zizhenji/ECE295_subsystemA-B/diagrams/prototype/subB_FFT.jpg

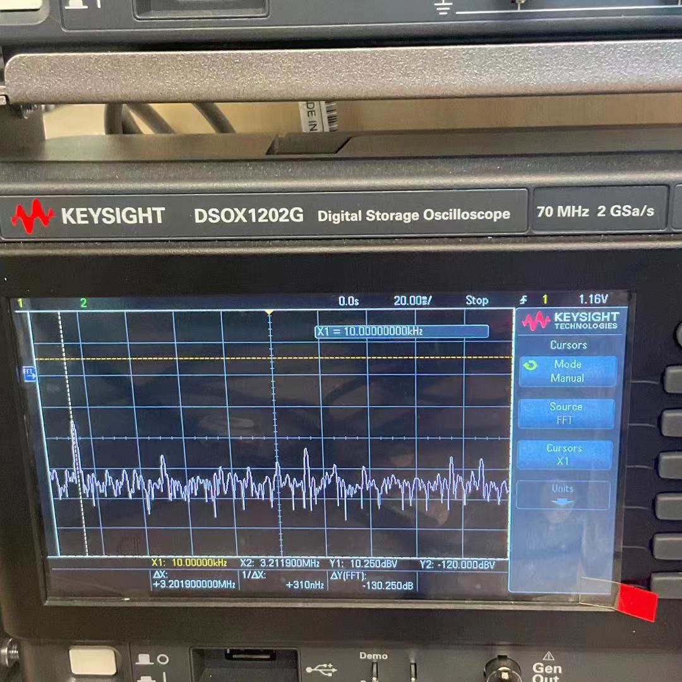
diagrams/prototype/subB_FFT.jpg
