zizhenji/ECE295_subsystemA-B/diagrams/flywire.jpg

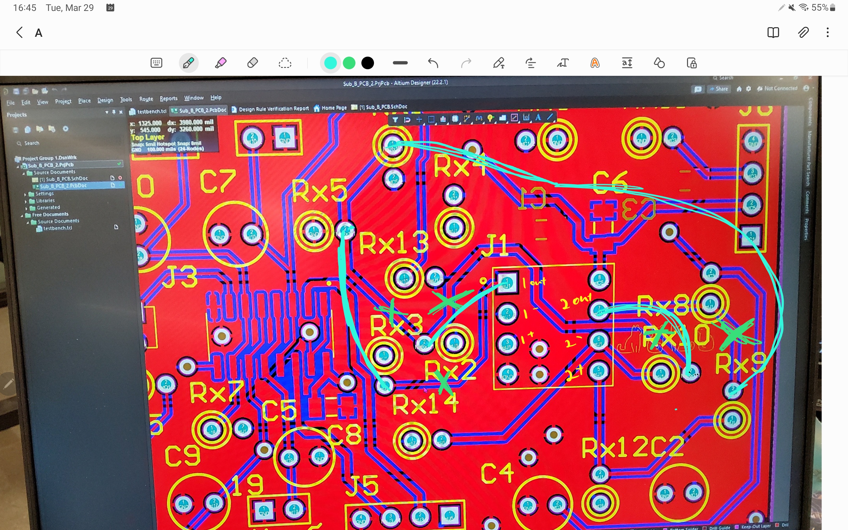
diagrams/flywire.jpg
