zizhenji/ECE295_subsystemA-B/diagrams/8MHz_drop.png

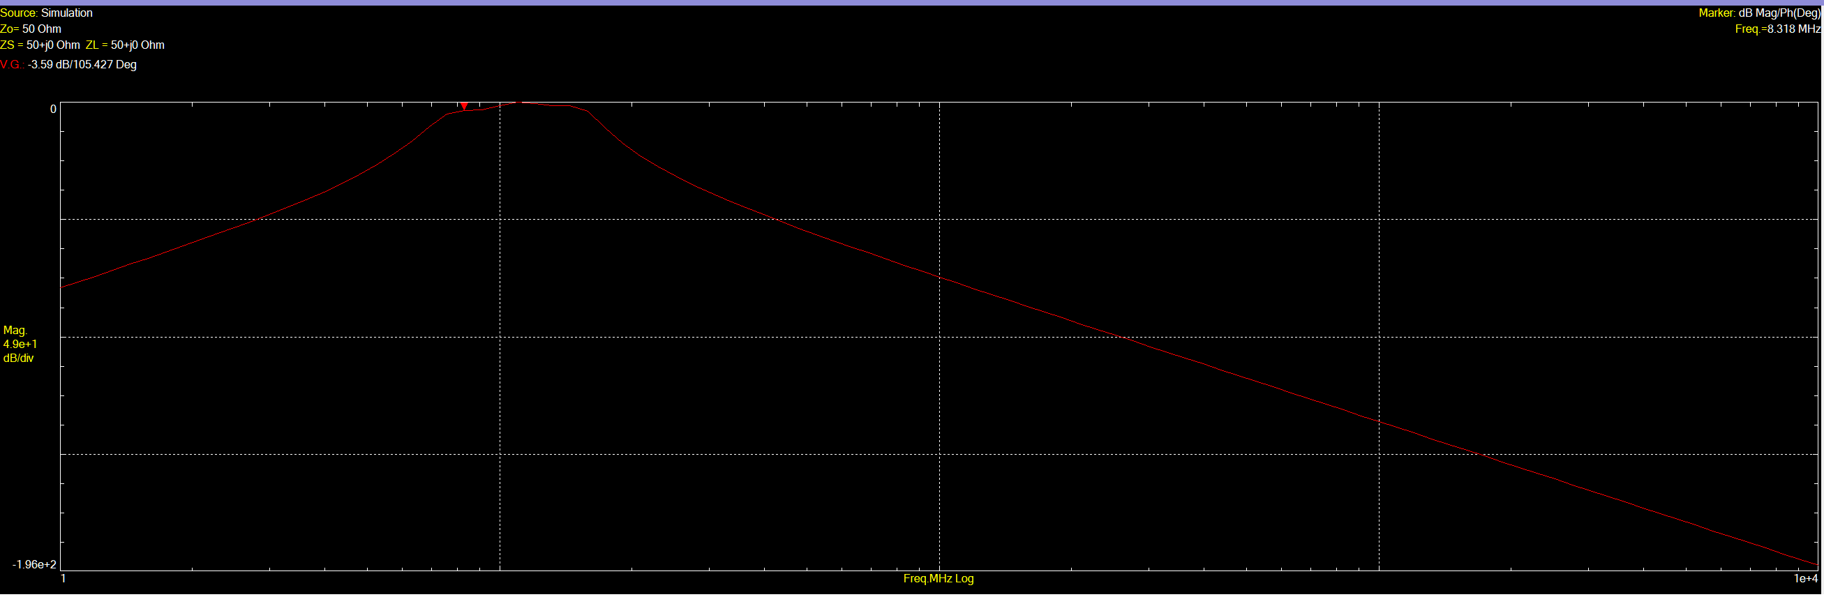
diagrams/8MHz_drop.png
