zizhenji/ECE295_subsystemA-B/diagrams/16MHz_drop.png

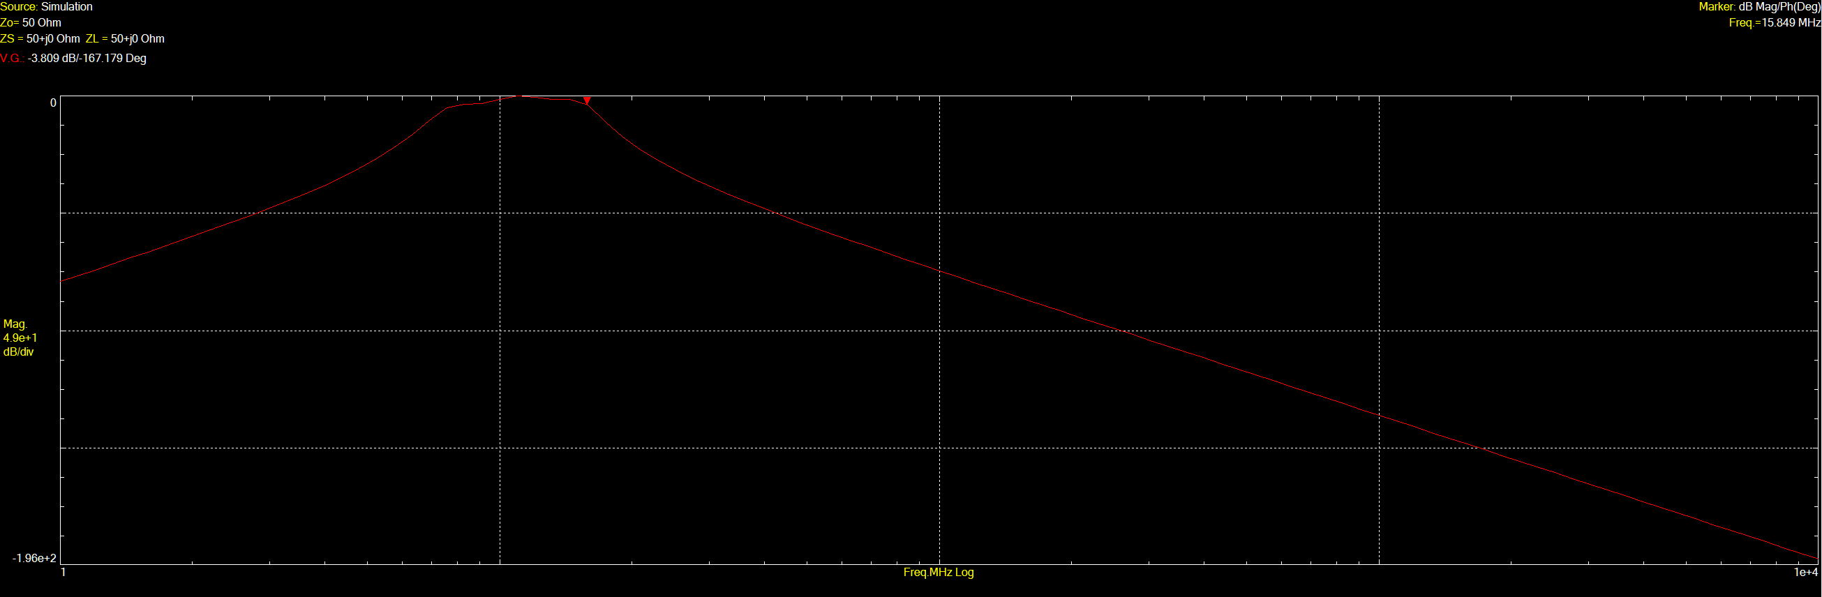
diagrams/16MHz_drop.png
