zizhenji/ECE295_subsystemA-B/diagrams/96kHz_LPF.png

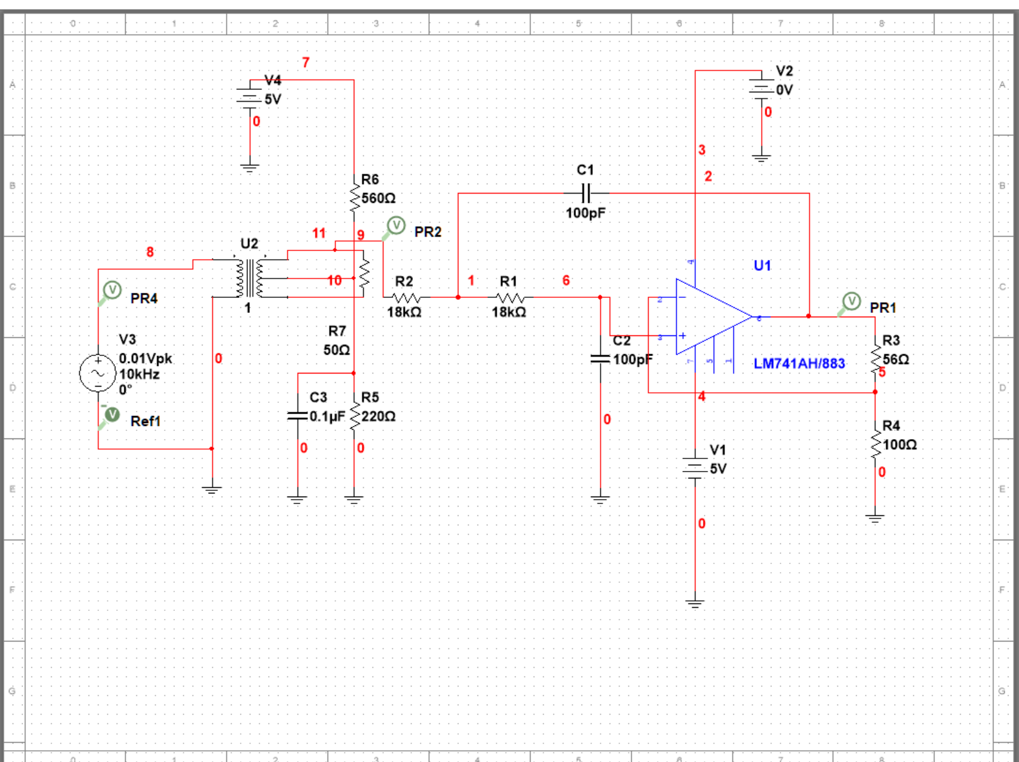
diagrams/96kHz_LPF.png
