zizhenji/ECE295_subsystemA-B/diagrams/A_BPF_sche.png

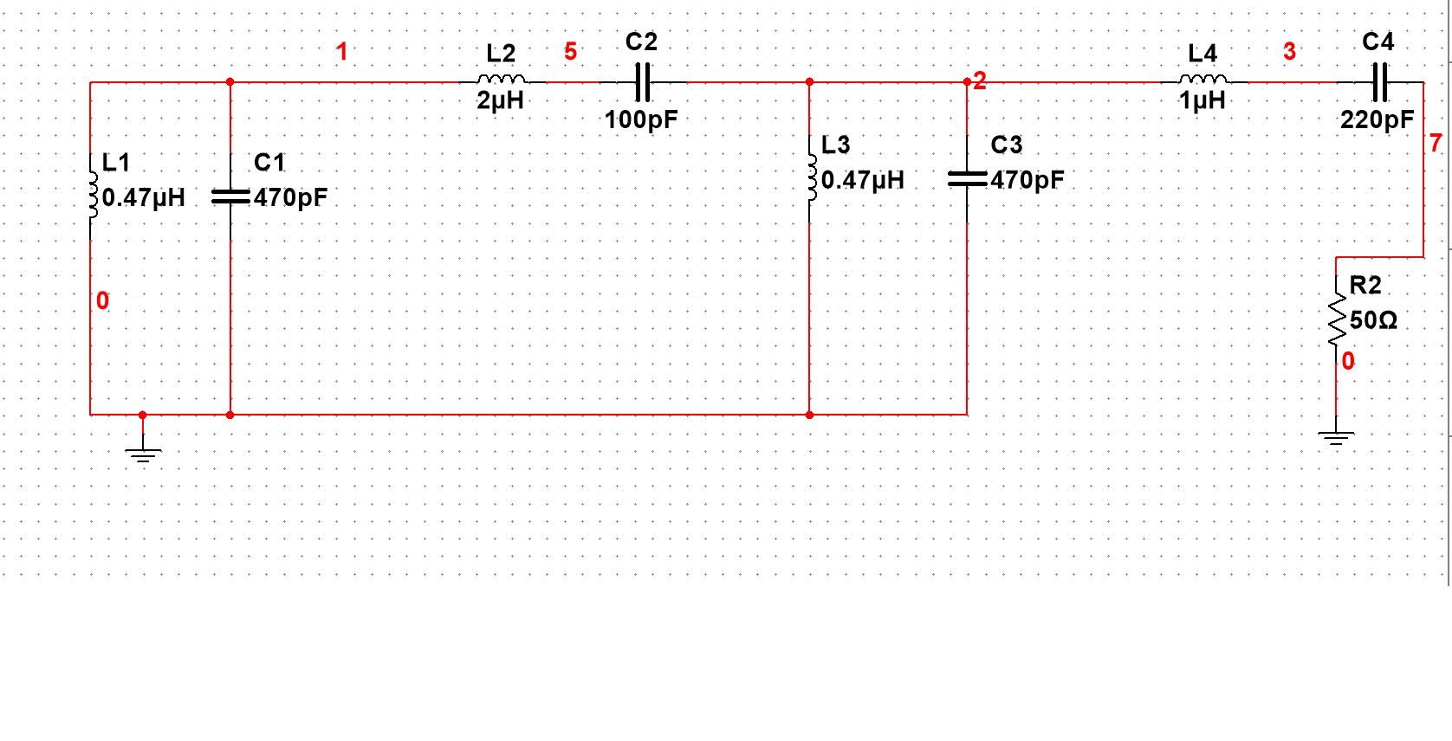
diagrams/A_BPF_sche.png
