zizhenji/ECE295_subsystemA-B/diagrams/I_fourier.png

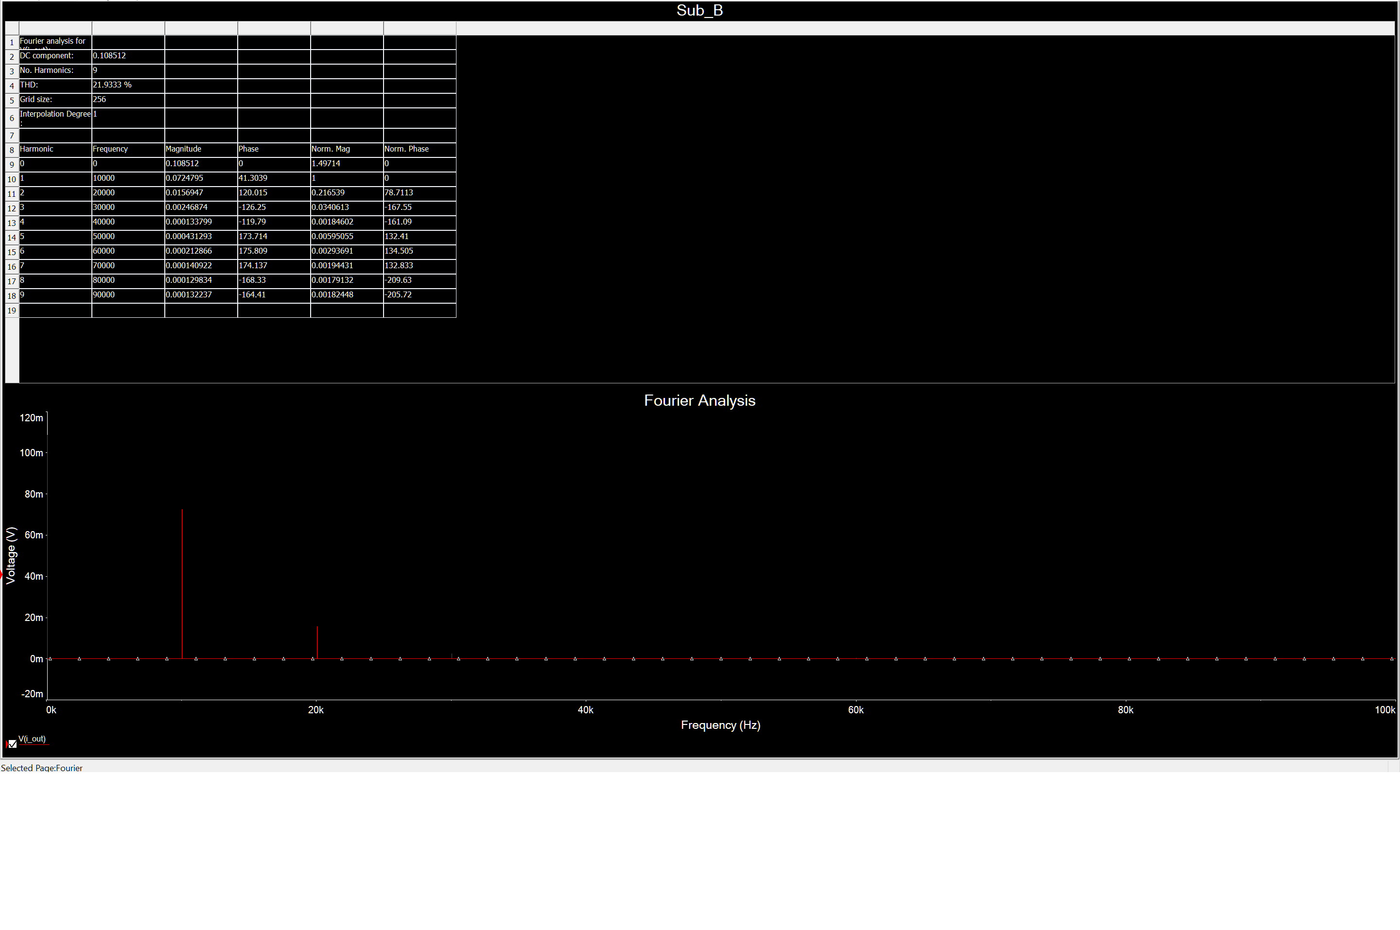
diagrams/I_fourier.png
