zizhenji/ECE295_subsystemA-B/diagrams/limiter_clip.png

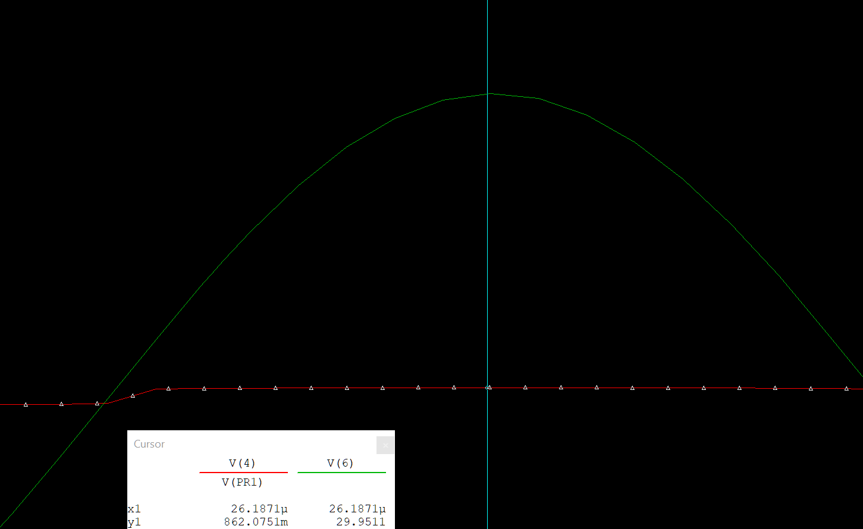
diagrams/limiter_clip.png
