zizhenji/ECE295_subsystemA-B/diagrams/limiter_sche.png

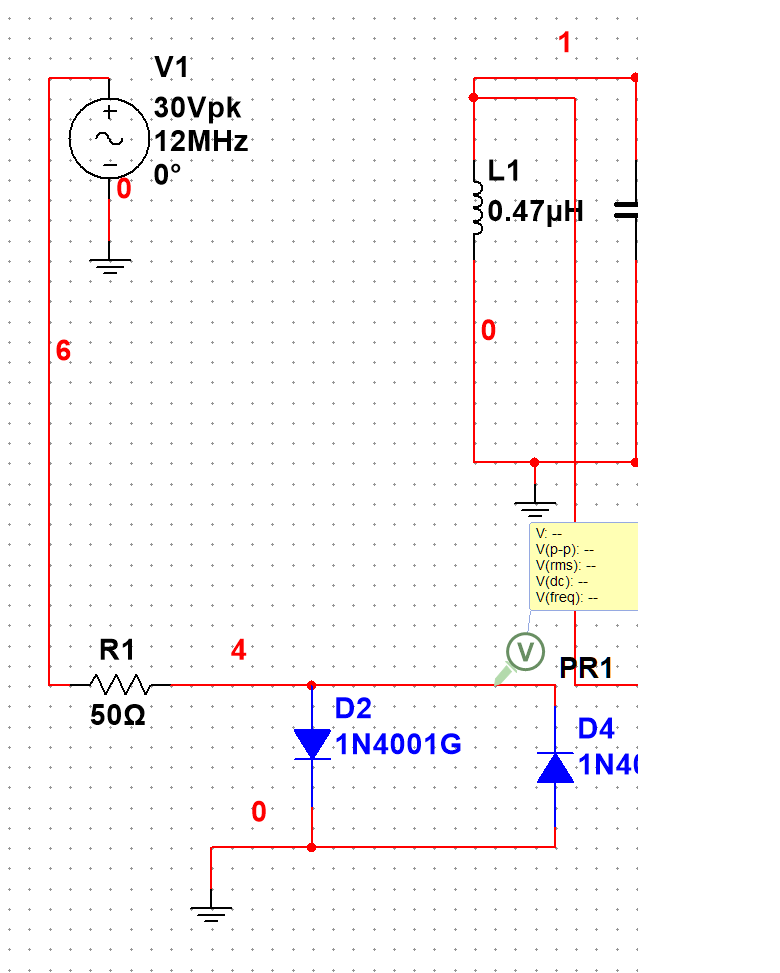
diagrams/limiter_sche.png
