zizhenji/ECE295_subsystemA-B/diagrams/LPF.png

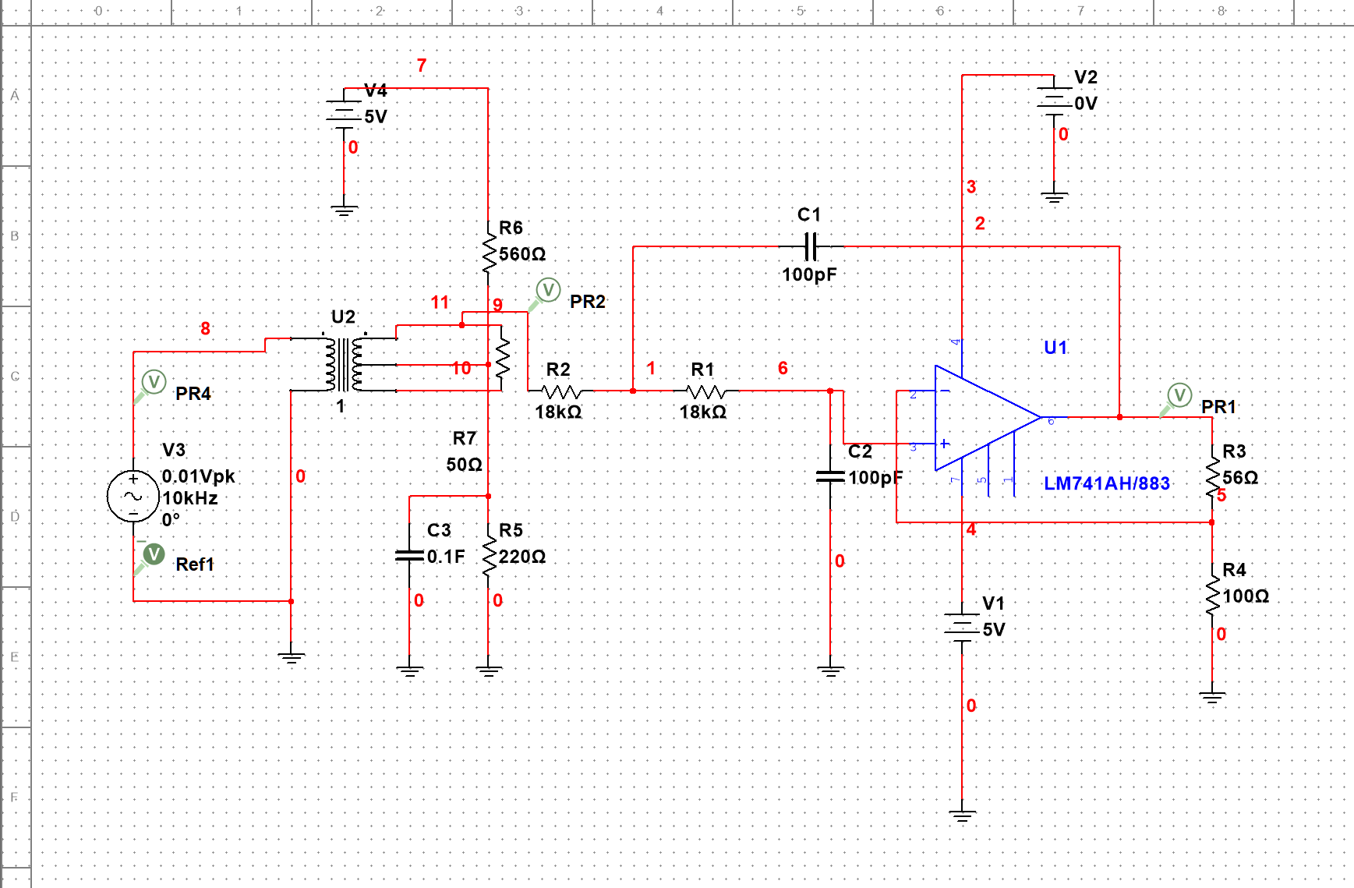
diagrams/LPF.png
