zizhenji/ECE295_subsystemA-B/diagrams/LPF_Frequency.png

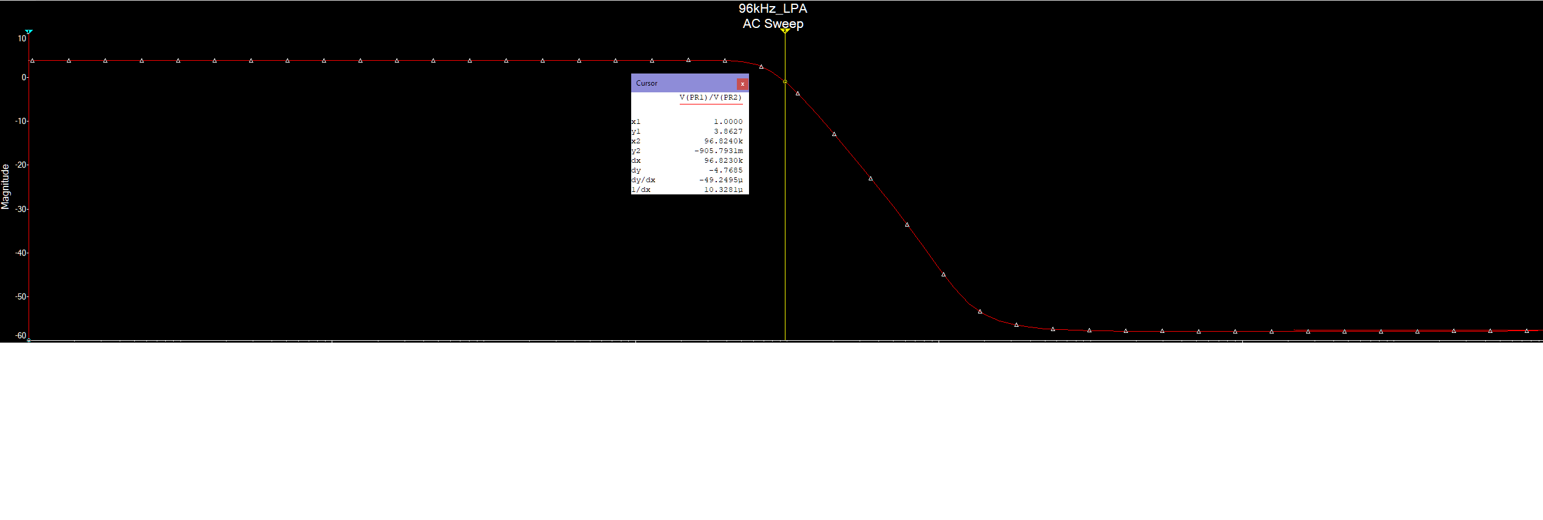
diagrams/LPF_Frequency.png
