zizhenji/ECE295_subsystemA-B/diagrams/mixer.png

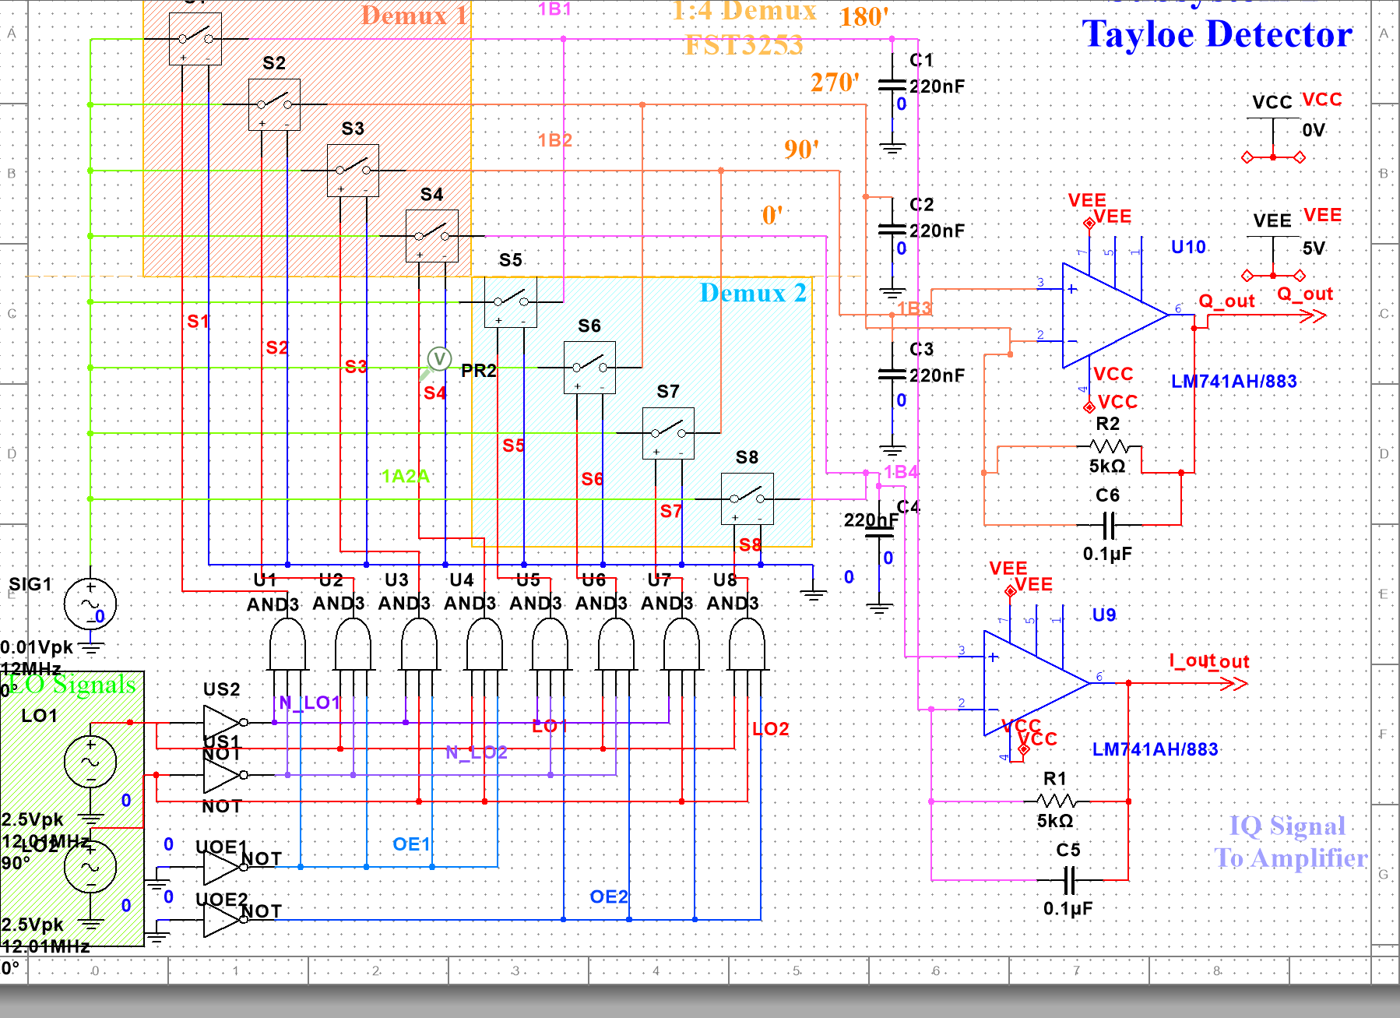
diagrams/mixer.png
