zizhenji/ECE295_subsystemA-B/diagrams/mixer_sch.png

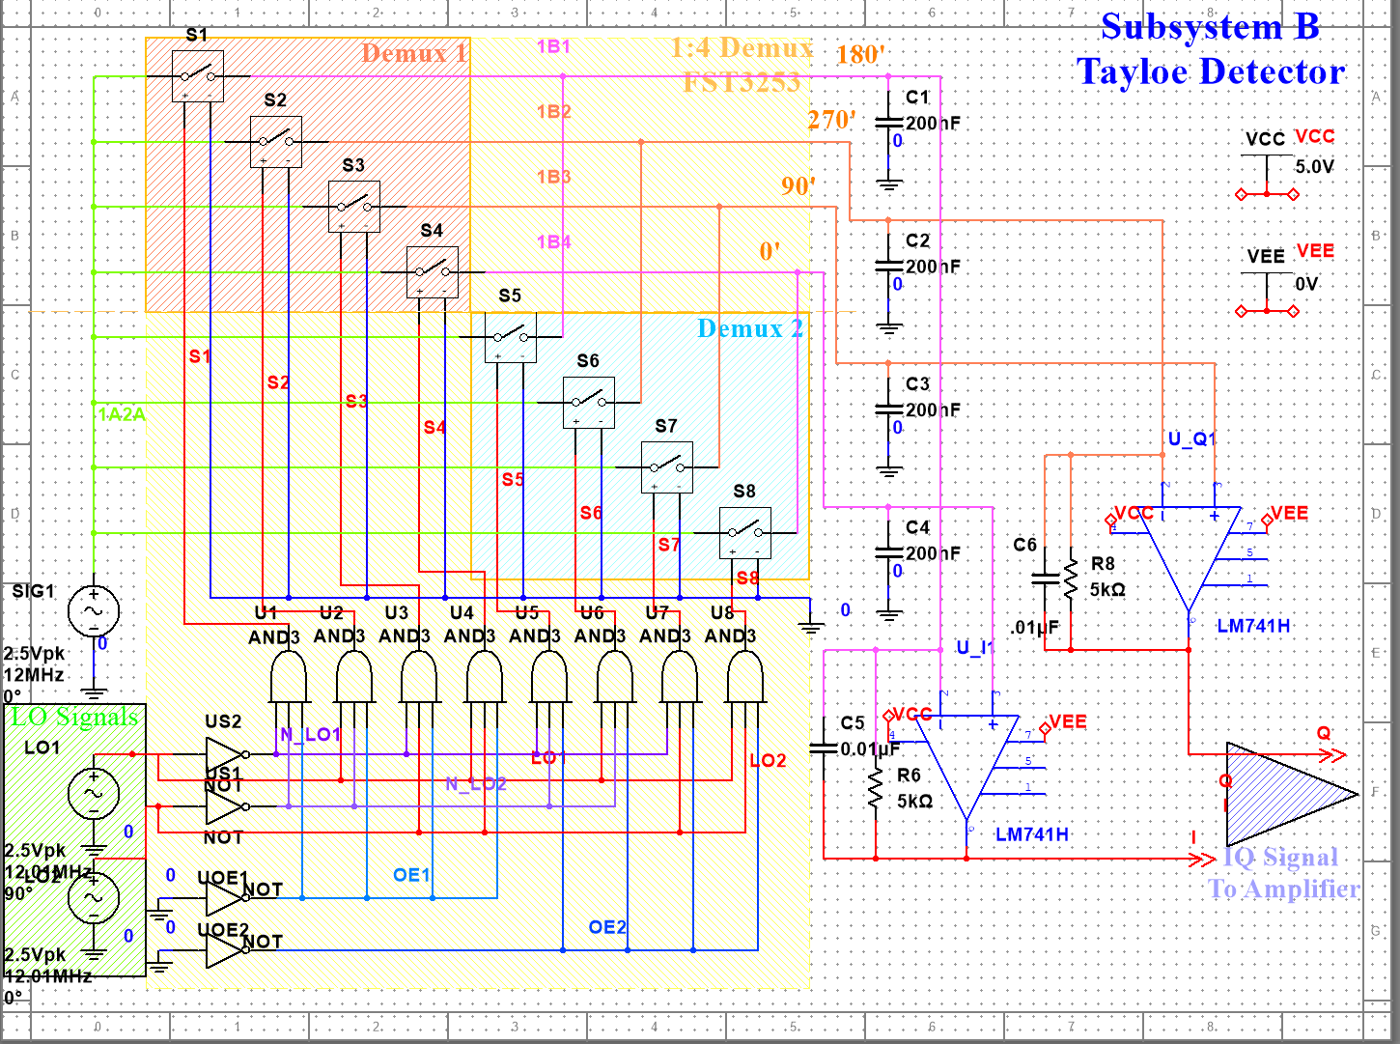
diagrams/mixer_sch.png
