zizhenji/ECE295_subsystemA-B/diagrams/prototype/sub_A_8Mhz.jpg

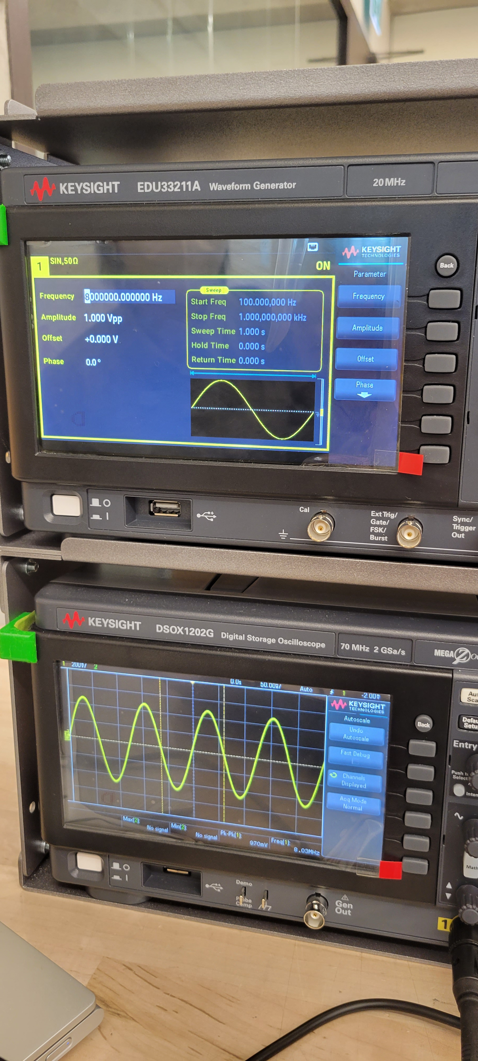
diagrams/prototype/sub_A_8Mhz.jpg
