zizhenji/ECE295_subsystemA-B/diagrams/prototype/sub_A_12Mhz.jpg

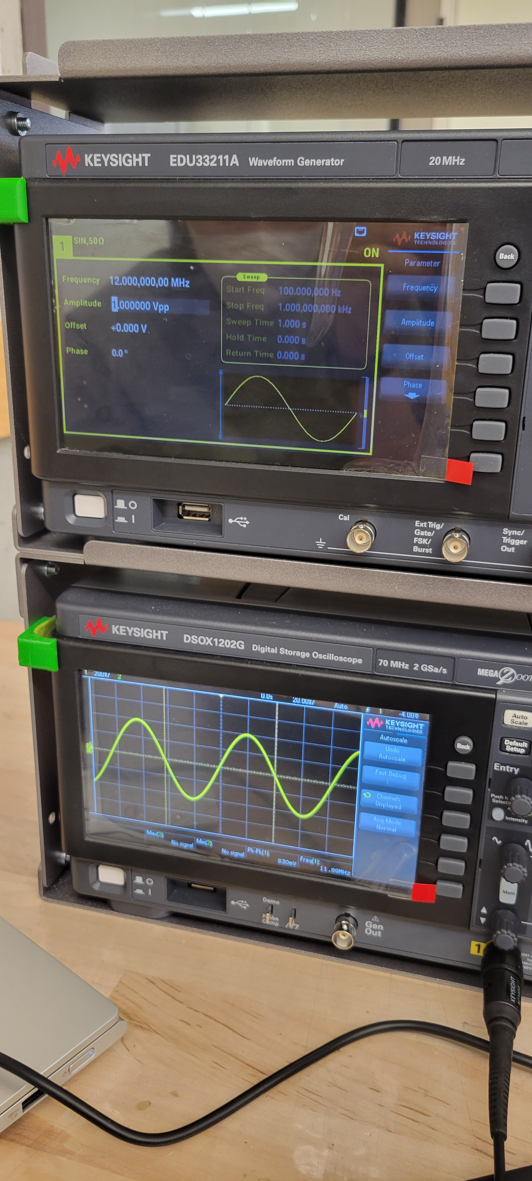
diagrams/prototype/sub_A_12Mhz.jpg
