zizhenji/ECE295_subsystemA-B/diagrams/prototype/sub_A_16Mhz.jpg

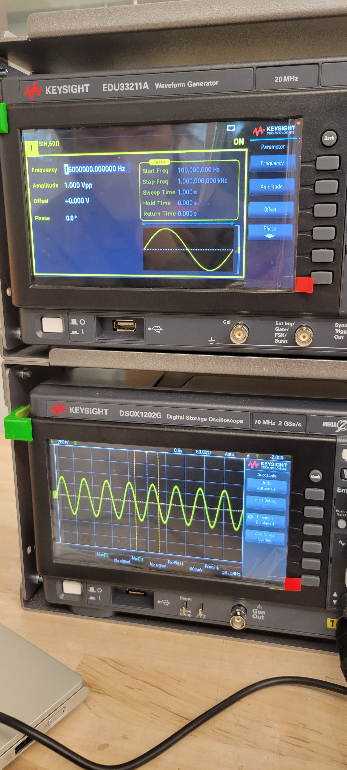
diagrams/prototype/sub_A_16Mhz.jpg
