zizhenji/ECE295_subsystemA-B/diagrams/prototype/sub_A_17MHz.jpg

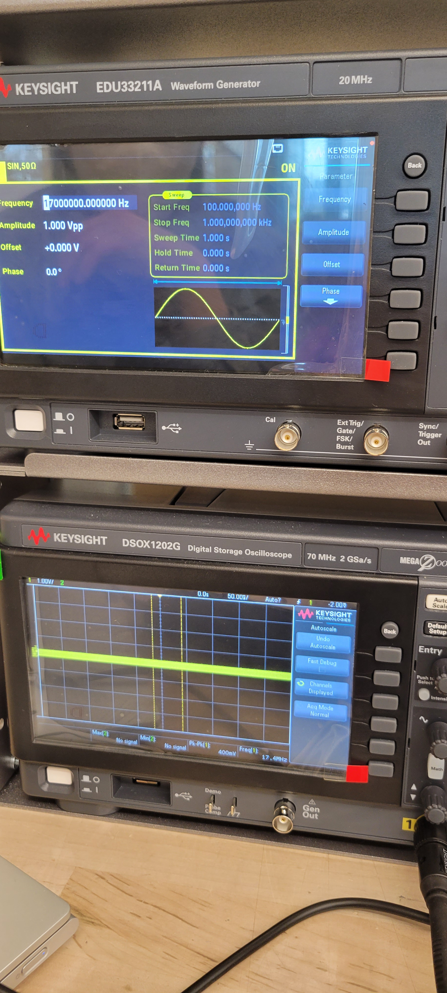
diagrams/prototype/sub_A_17MHz.jpg
