zizhenji/ECE295_subsystemA-B/diagrams/prototype/sub_A_prototype.jpg

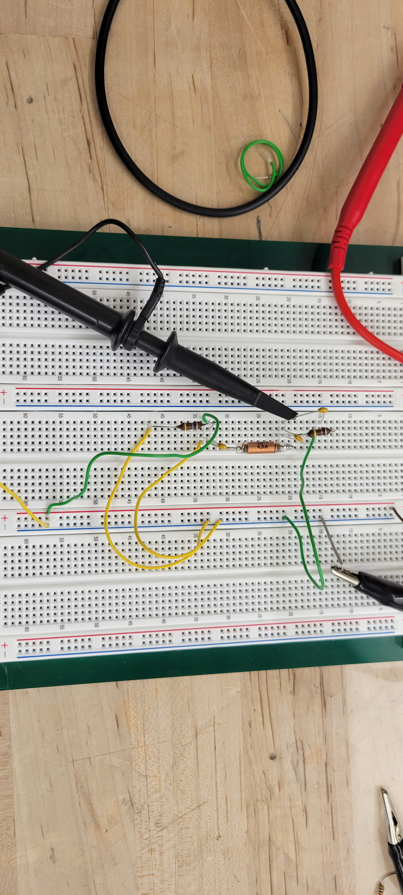
diagrams/prototype/sub_A_prototype.jpg
