zizhenji/ECE295_subsystemA-B/diagrams/prototype/subB_correct_schematic.png

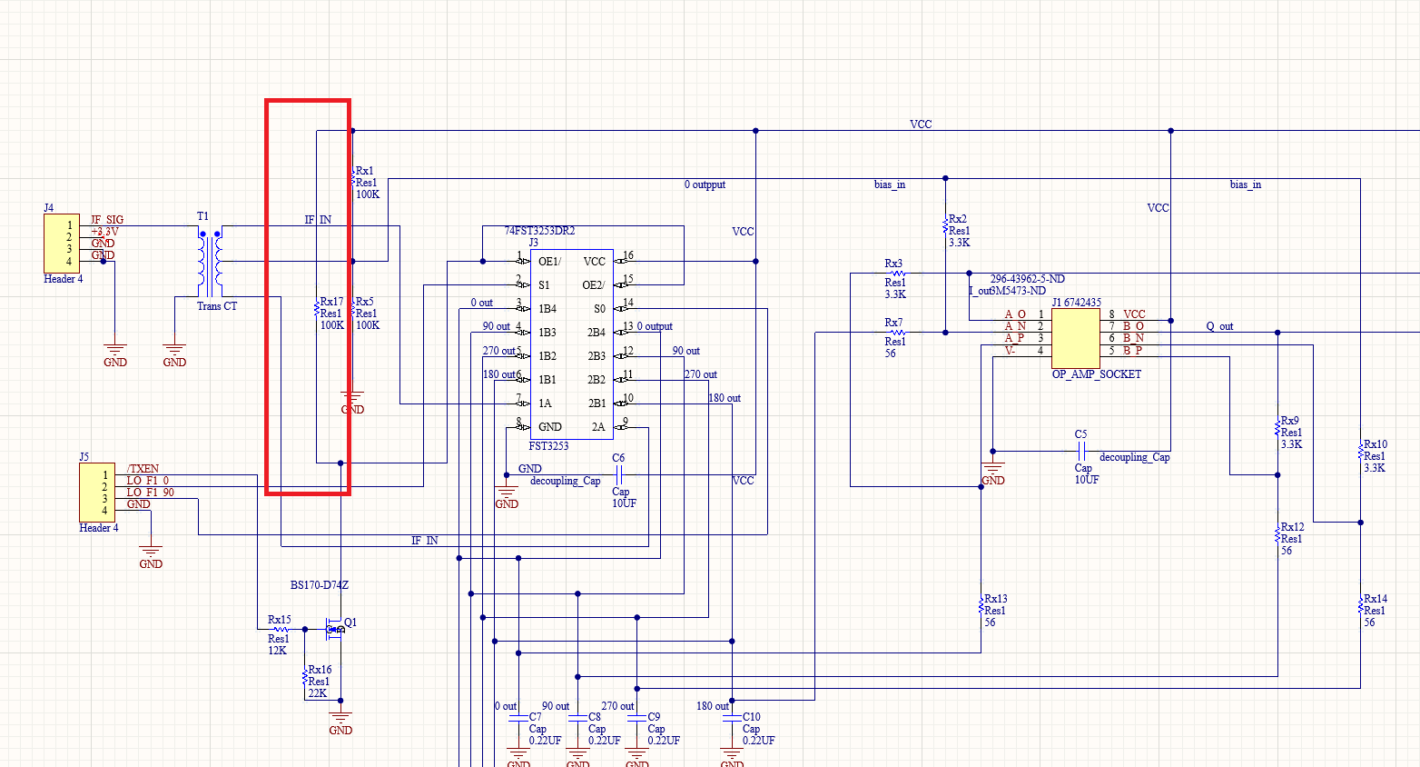
diagrams/prototype/subB_correct_schematic.png
