zizhenji/ECE295_subsystemA-B/diagrams/prototype/subB_input.jpg

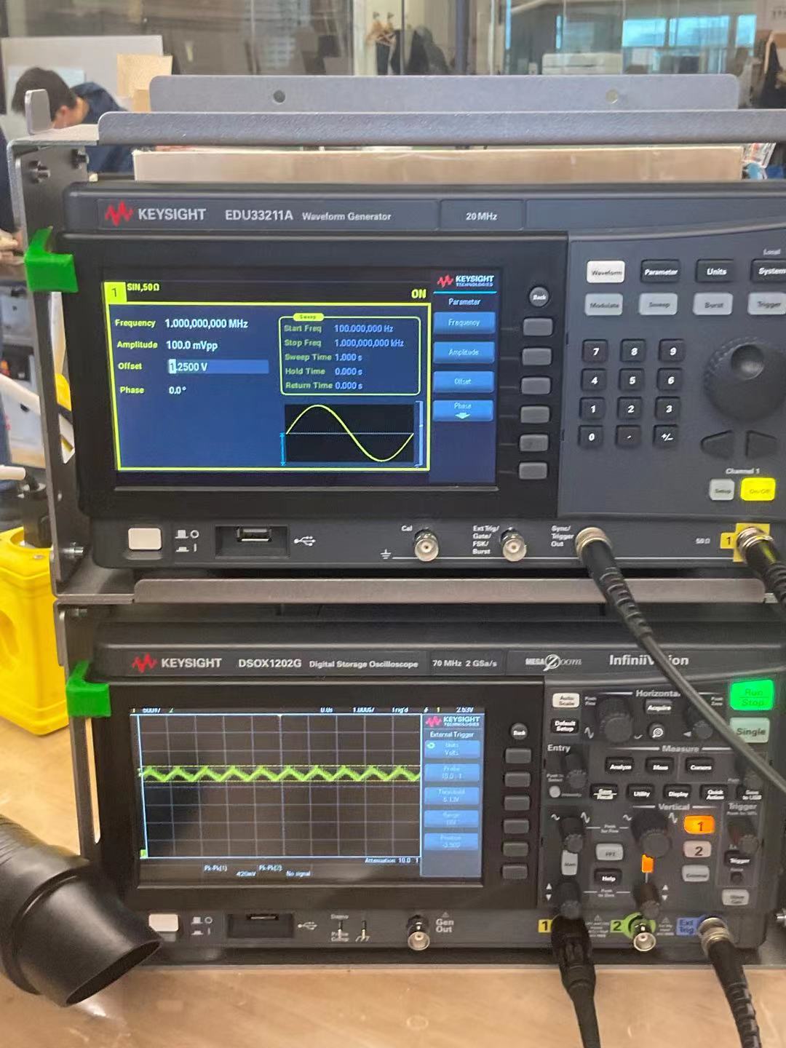
diagrams/prototype/subB_input.jpg
