zizhenji/ECE295_subsystemA-B/diagrams/prototype/subB_single_balanced_output.jpg

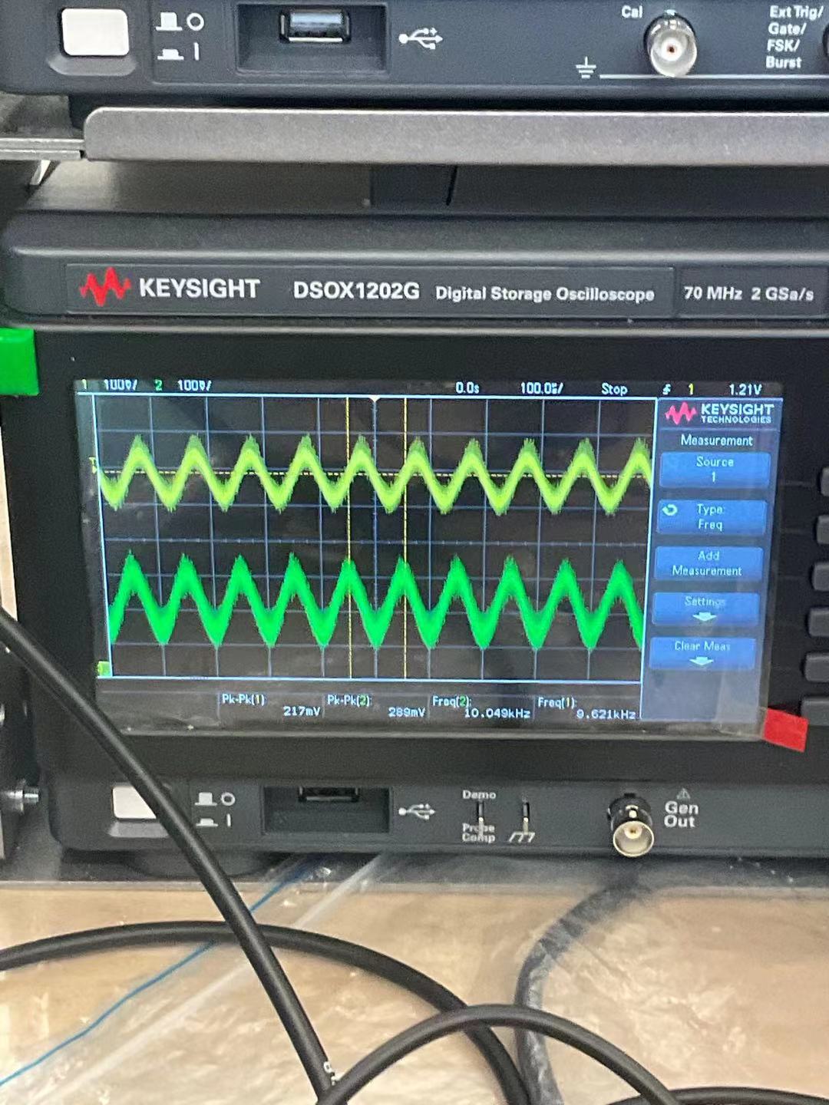
diagrams/prototype/subB_single_balanced_output.jpg
