zizhenji/ECE295_subsystemA-B/diagrams/prototype/subb_wrong_schematic.png

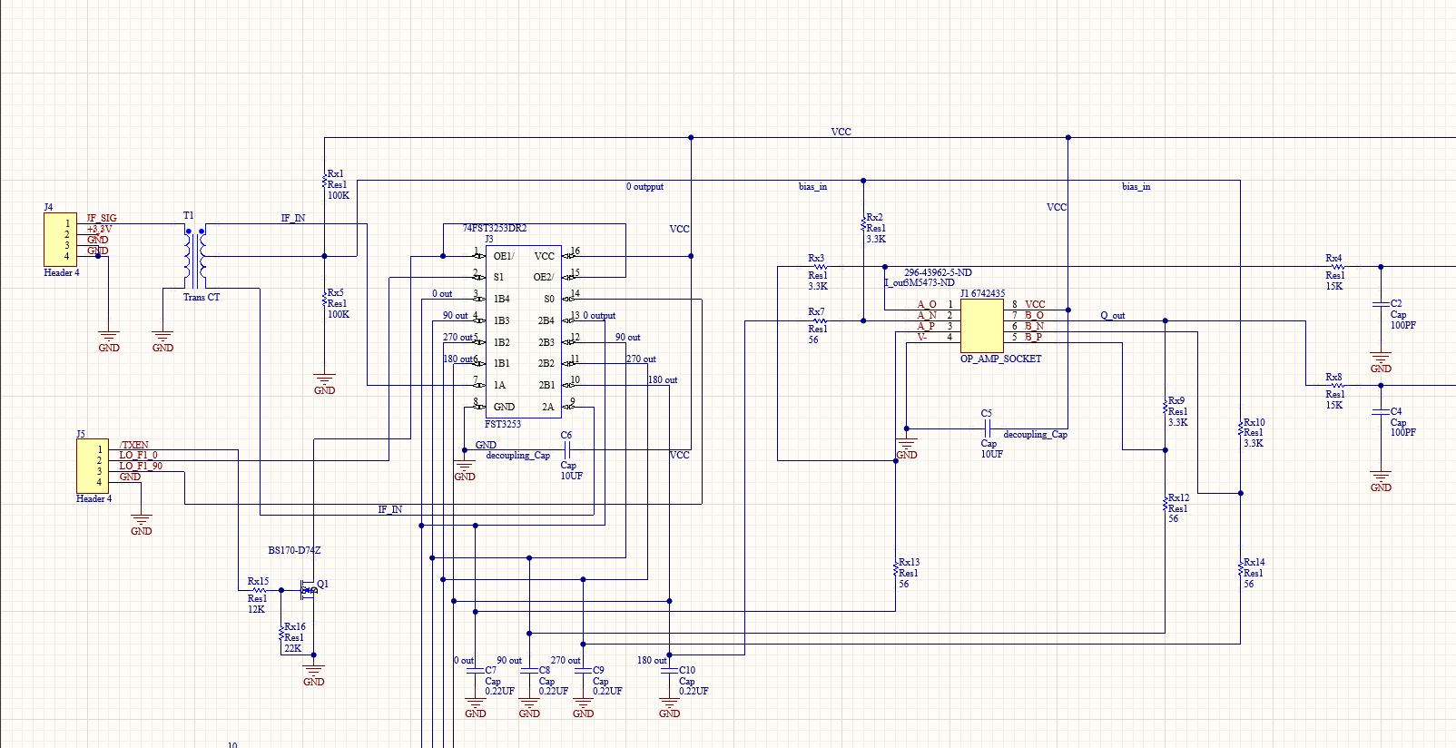
diagrams/prototype/subb_wrong_schematic.png
