zizhenji/ECE295_subsystemA-B/diagrams/Sam_flywire/bottomlayter.png

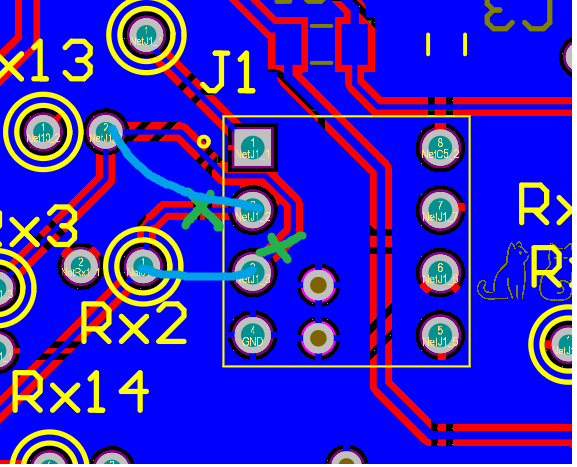
diagrams/Sam_flywire/bottomlayter.png
