zizhenji/ECE295_subsystemA-B/diagrams/Sam_flywire/toplevel.png

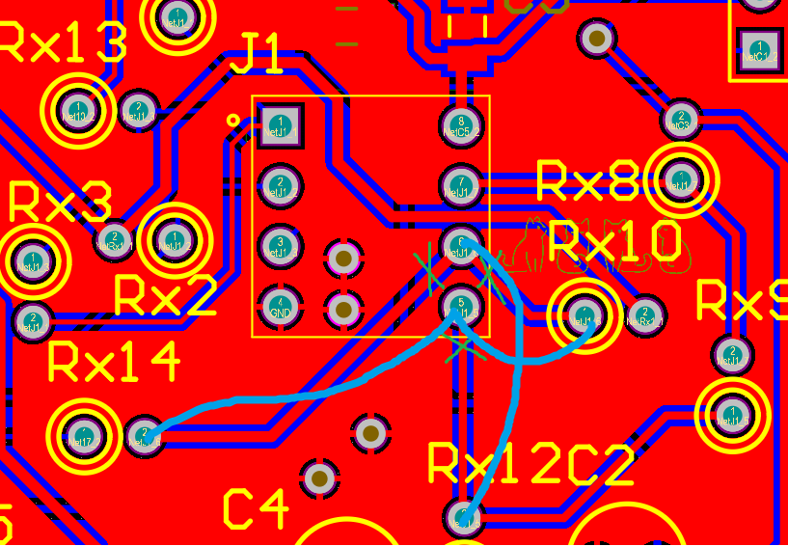
diagrams/Sam_flywire/toplevel.png
