zizhenji/ECE295_subsystemA-B/diagrams/Tayloe.png

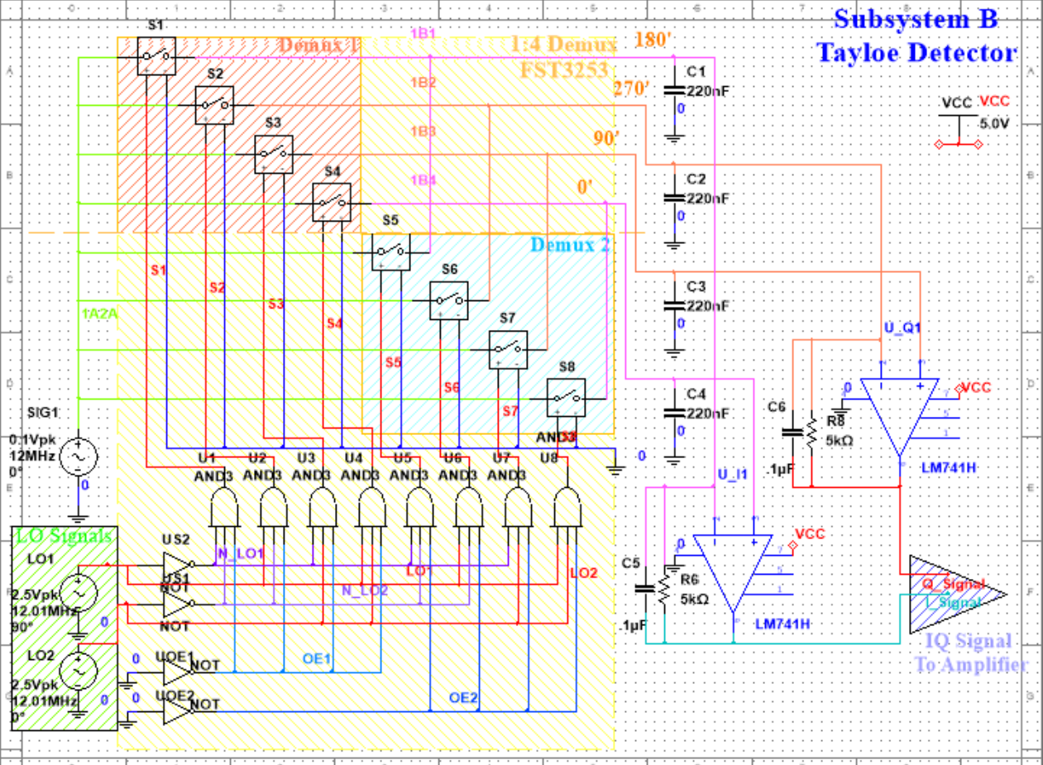
diagrams/Tayloe.png
