zizhenji/ECE295_subsystemA-B/diagrams/TLV2462_prototype.jpg

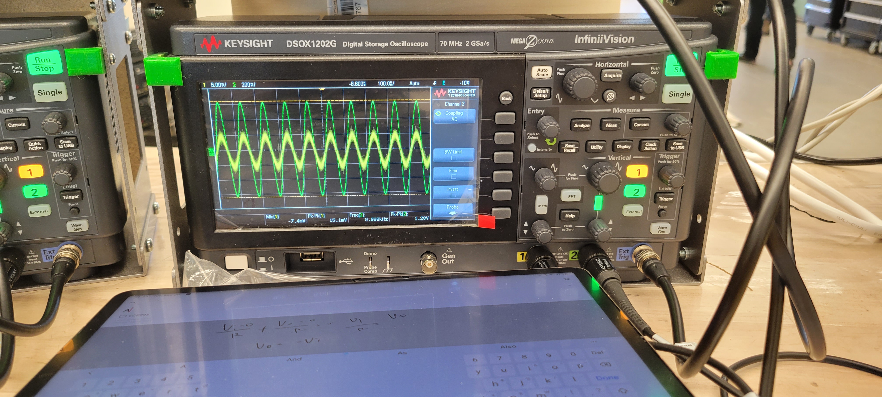
diagrams/TLV2462_prototype.jpg
