zizhenji/ECE295_subsystemA-B/PCB_design_record/A_PCB_3D_back_mar.8.png

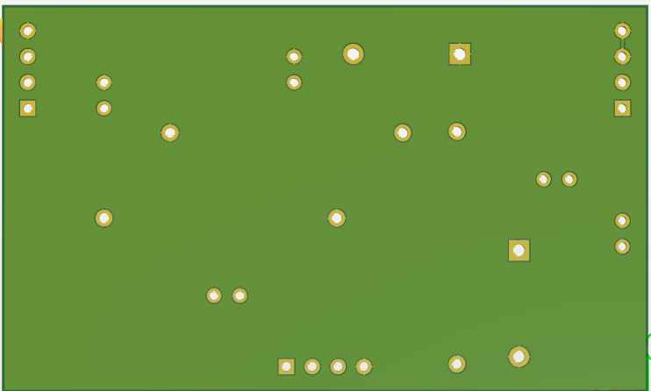
PCB_design_record/A_PCB_3D_back_mar.8.png
