zizhenji/ECE295_subsystemA-B/PCB_design_record/A_PCB_3D_Front_Mar.8.png

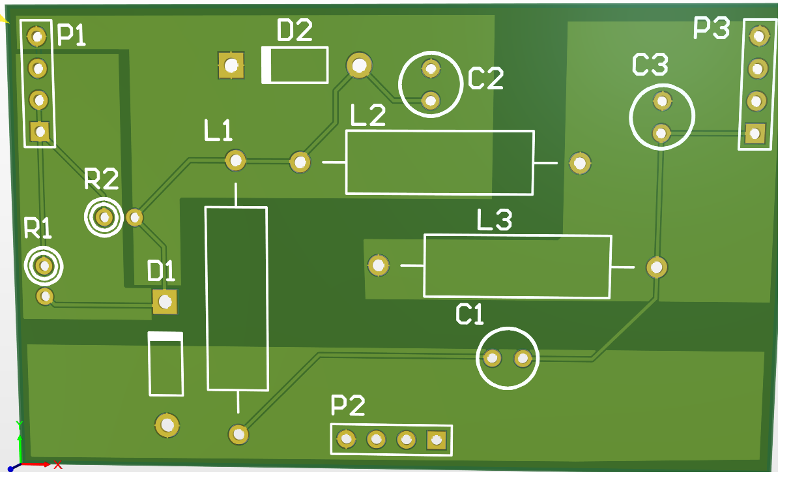
PCB_design_record/A_PCB_3D_Front_Mar.8.png
