zizhenji/ECE295_subsystemA-B/PCB_design_record/A_PCB_Mar_8.png

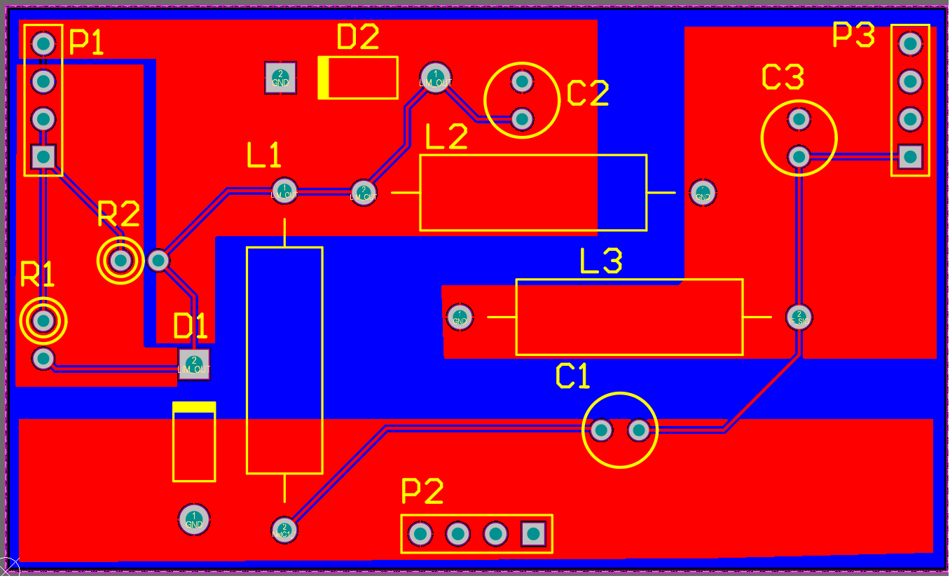
PCB_design_record/A_PCB_Mar_8.png
