zizhenji/ECE295_subsystemA-B/PCB_design_record/A_SCHEMATIC_MAR_9.png

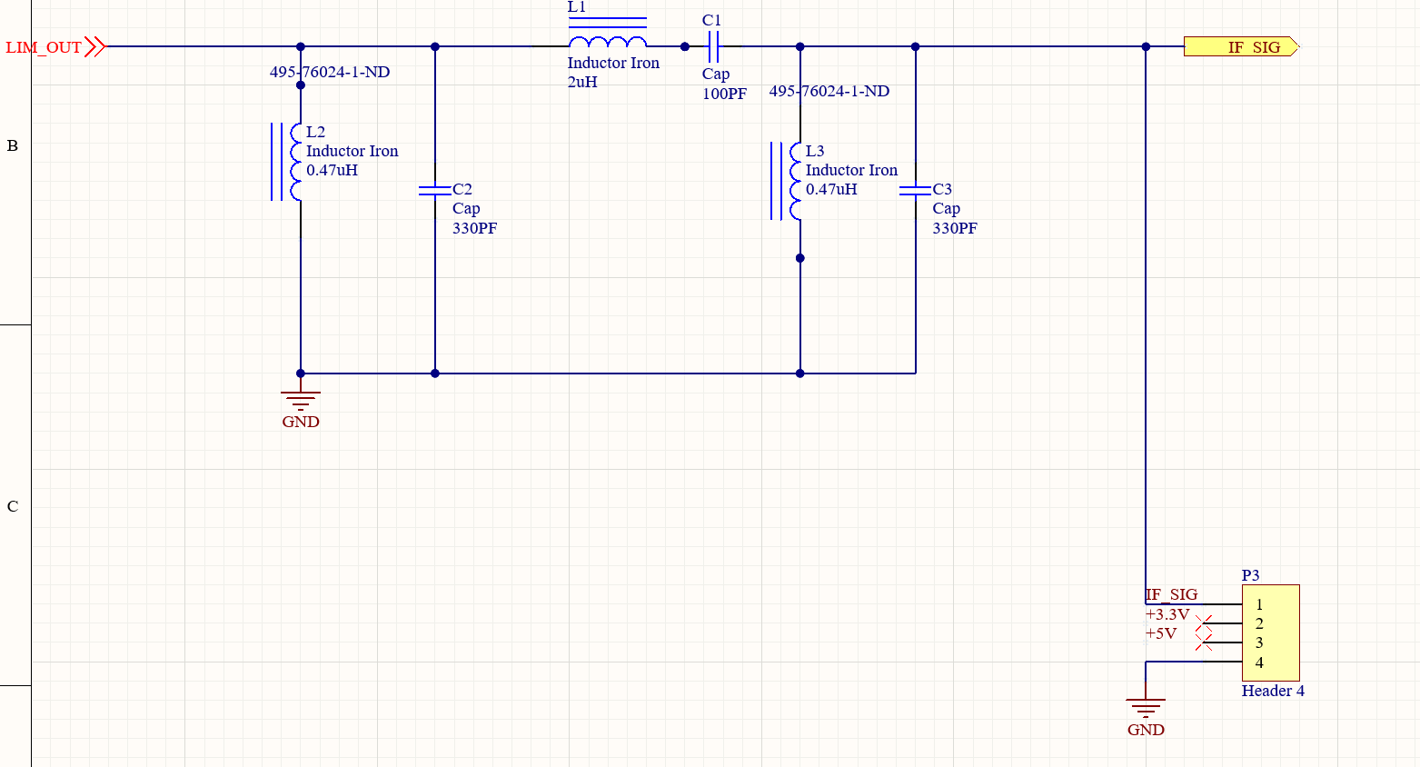
PCB_design_record/A_SCHEMATIC_MAR_9.png
