zizhenji/ECE295_subsystemA-B/PCB_design_record/B_PCB_Mar_11.png

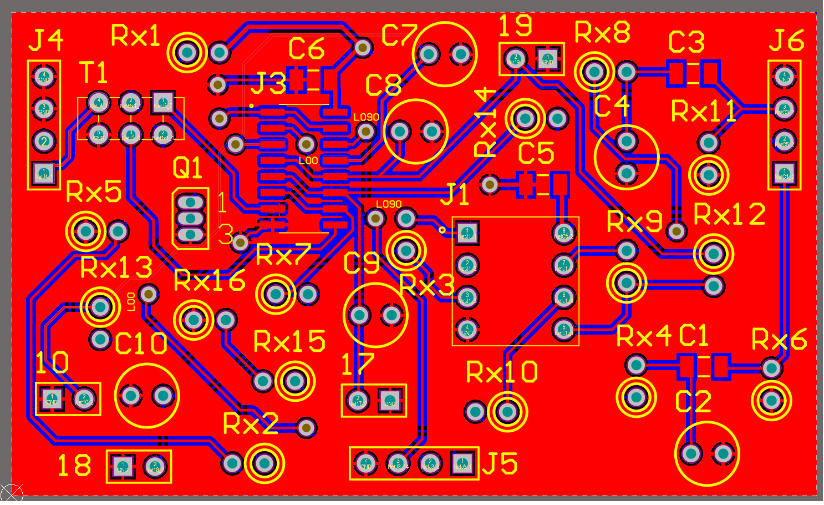
PCB_design_record/B_PCB_Mar_11.png
