zizhenji/ECE295_subsystemA-B/PCB_design_record/B_PCB_Mar_12.png

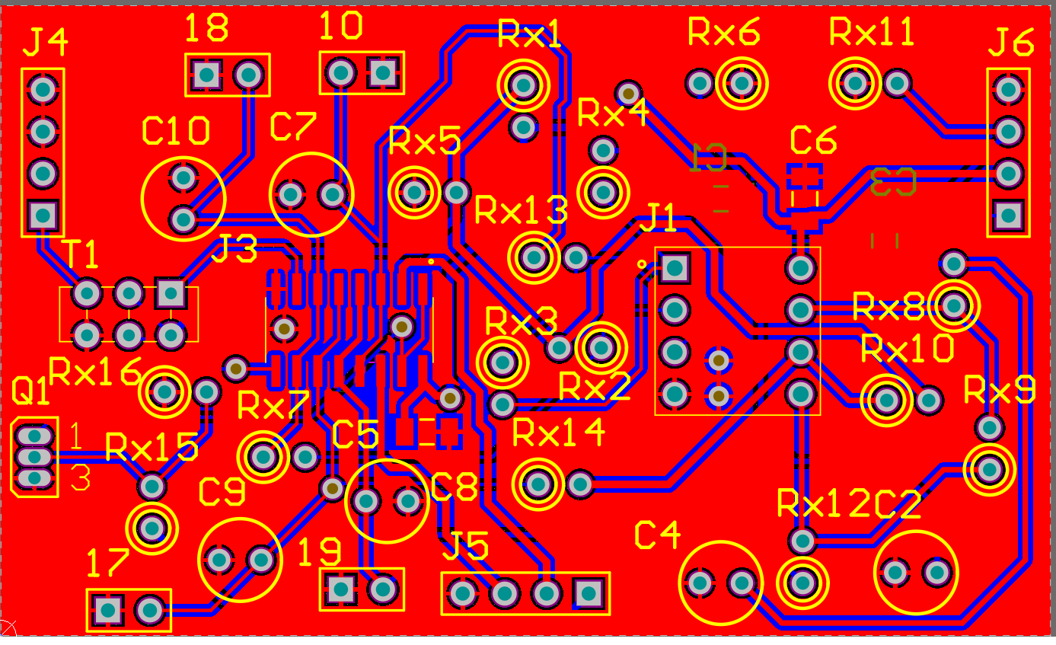
PCB_design_record/B_PCB_Mar_12.png
