zizhenji/ECE295_subsystemA-B/PCB_design_record/B_Schematic_Mar-12.png

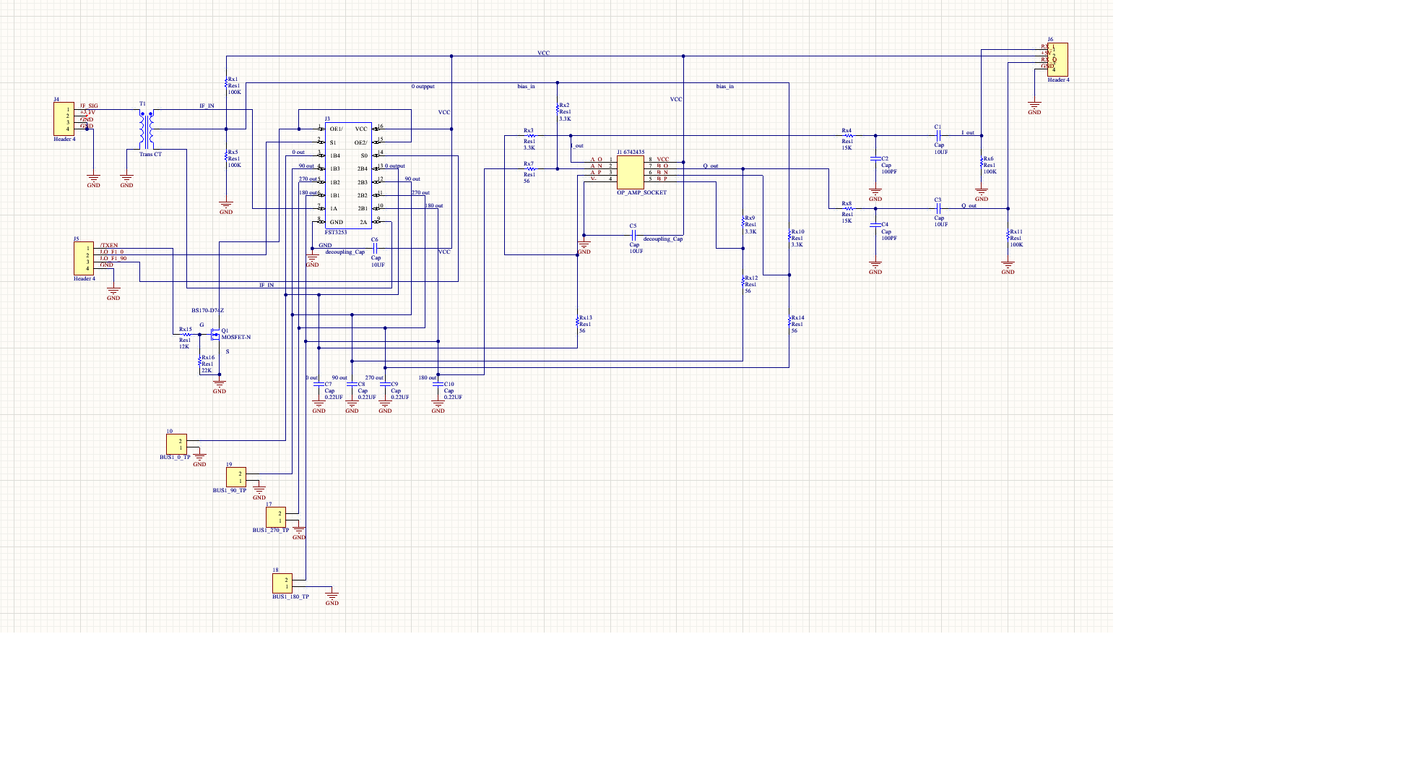
PCB_design_record/B_Schematic_Mar-12.png
