zizhenji/ECE295_subsystemA-B/PCB_design_record/B_SCHEMATIC_MAR.9.png

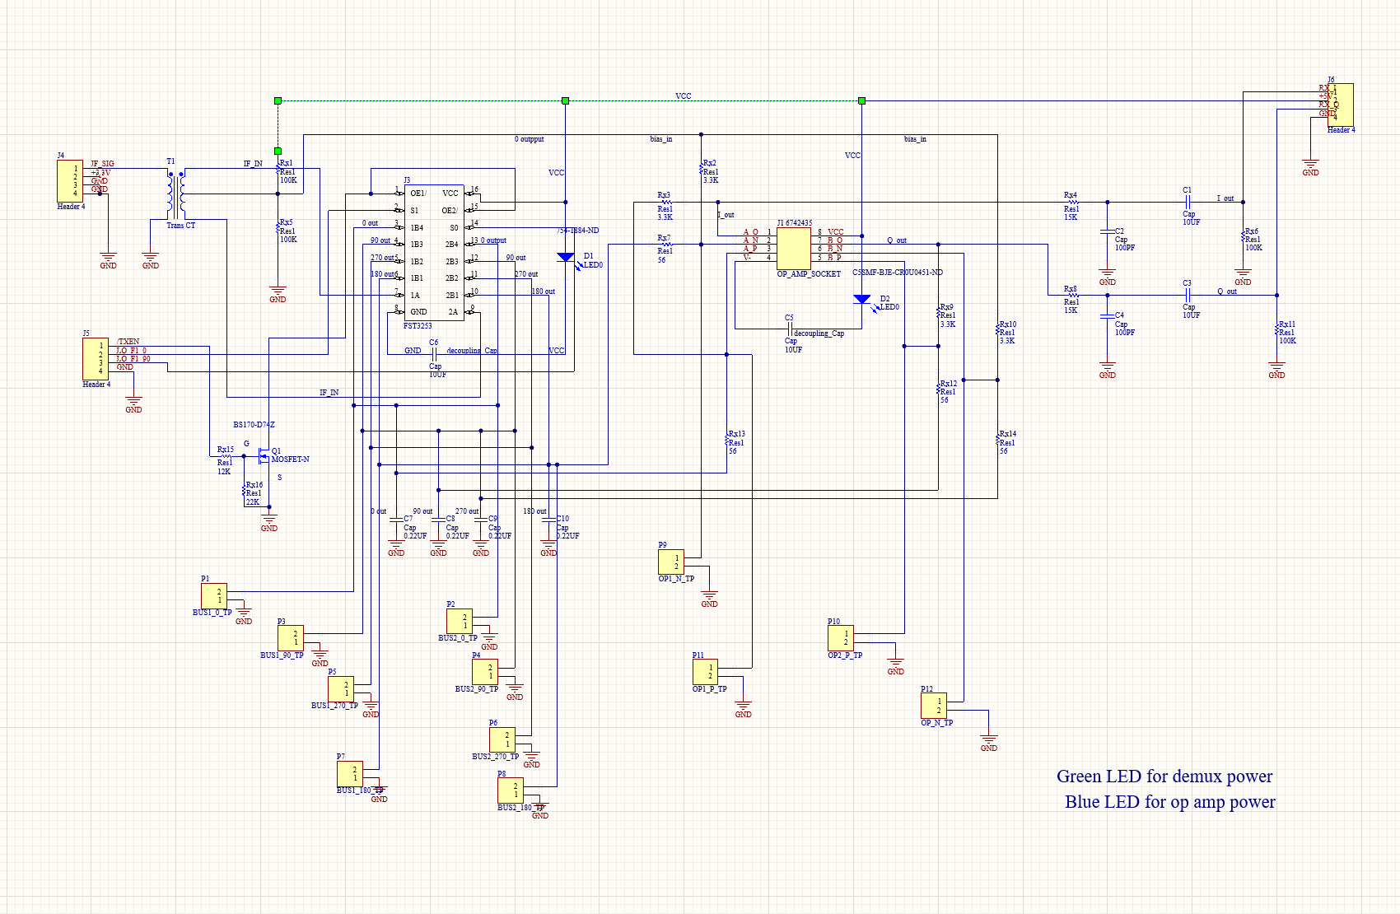
PCB_design_record/B_SCHEMATIC_MAR.9.png
