zizhenji/ECE295_subsystemA-B/BOM.xlsx

Comment | Description | Designator | Footprint | LibRef | Quantity
Op Amp | FET Operational Amplifier | AR1_U_96kHz_LPF1, AR1_U_96kHz_LPF2, AR2_U_IQ_AMP1, AR2_U_IQ_AMP2, AR3, AR4 | H-08A | Op Amp | 6
Cap | Capacitor | C1, C2, C3, C4, C5_U_96kHz_LPF1, C5_U_96kHz_LPF2, C6_U_96kHz_LPF1, C6_U_96kHz_LPF2, C7_U_96kHz_LPF1, C7_U_96kHz_LPF2, C12, C13, C14, C15 | RADIAL-0.1 | CAP CER 100PF 50V C0G/NP0 RADIAL, CAP CER 220PF 50V X7R RADIAL, CAP CER 470PF 50V X7R RADIAL, CAP CER 0.1UF 50V X7R RADIAL, CAP CER 1000PF 50V Z5U RADIAL, CAP CER 0.022UF 50V X7R RADIAL | 14
Cap | Capacitor | C8_U_IQ_AMP1, C8_U_IQ_AMP2, C9_U_IQ_AMP1, C9_U_IQ_AMP2 | 1206 | CAP CER 0.1UF 50V X7R 1206 | 4
 | Capacitor | C10, C11 | RADIAL-0.1 | CAP CER 0.022UF 50V X7R RADIAL | 2
Diode 1N4001 | 1 Amp General Purpose Rectifier | D1, D2 | DO-41 | Diode 1N4001 | 2
Inductor | Inductor | L1, L2, L3, L4 | TORIND-T25 | Toroidal inductor ferrite core | 4
Header 8X2 | Header, 8-Pin, Dual row | P1 | HDR2X8 | Header 8X2 | 1
MOSFET-N | N-Channel MOSFET | Q1 | E3 | MOSFET-N | 1
Res1 | Resistor | R1, R2, R3, R4, Rx1_U_96kHz_LPF1, Rx1_U_96kHz_LPF2, Rx2_U_96kHz_LPF1, Rx2_U_96kHz_LPF2, Rx3_U_96kHz_LPF1, Rx3_U_96kHz_LPF2, Rx4_U_96kHz_LPF1, Rx4_U_96kHz_LPF2, Rx5_U_96kHz_LPF1, Rx5_U_96kHz_LPF2, Rx6_U_96kHz_LPF1, Rx6_U_96kHz_LPF2, Rx7_U_96kHz_LPF1, Rx7_U_96kHz_LPF2, Rx8_U_96kHz_LPF1, Rx8_U_96kHz_LPF2, Rx9_U_IQ_AMP1, Rx9_U_IQ_AMP2, Rx10_U_IQ_AMP1, Rx10_U_IQ_AMP2, Rx11_U_IQ_AMP1, Rx11_U_IQ_AMP2, Rx12_U_IQ_AMP1, Rx12_U_IQ_AMP2, Rx13_U_IQ_AMP1, Rx13_U_IQ_AMP2, Rx14, Rx15, Rx16, Rx17, Rx18, Rx19, Rx20, Rx21, Rx22, Rx23, Rx24, Rx25, Rx26, Rx27, Rx? | AXIAL-0.1-RES | RES 100 OHM 5% 1/4W AXIAL, RES 4.7K OHM 5% 1/4W AXIAL, RES 560 OHM 5% 1/4W AXIAL, RES 18K OHM 5% 1/4W AXIAL, RES 56 OHM 5% 1/4W AXIAL, RES 220 OHM 5% 1/4W AXIAL, RES 100K OHM 5% 1/4W AXIAL, RES 27K OHM 5% 1/4W AXIAL, RES 1K OHM 5% 1/4W AXIAL, RES 22K OHM 5% 1/4W AXIAL, RES 10K OHM 5% 1/4W AXIAL, RES 12K OHM 5% 1/4W AXIAL | 45
Trans CT | Center-Tapped Transformer (Coupled Inductor Model) | T1_U_96kHz_LPF1, T1_U_96kHz_LPF2, T2, T3 | BIFILAR-2402 | Centre-tapped transformer wound on a binocular core | 4
