zizhenji/ECE295_subsystemA-B/BOM_Mar_20.xlsx

Comment | Description | Designator | Footprint | LibRef | Quantity | Manufacturer Part Number | Manufacturer Part Number 1 | Manufacturer Part Number 2 | Manufacturer Part Number 3 | Manufacturer Part Number 4 | Supplier Part Number 1 | Supplier Part Number 2 | Supplier Part Number 3 | Supplier Part Number 4 | Supplier 4 | Supplier 3 | Supplier 2 | Supplier 1
OP_AMP_SOCKET | 8 _2 x 4_ Pos DIP, 0.3 _7.62mm_ Row Spacing Socket Tin Through Hole | J1 | TE_1-2199298-2 | 1-2199298-2 | 1 |  |  |  |  |  |  | 6742435 | 3M5473-ND | 296-43962-5-ND | Digi-Key | Digi-Key | RSComponents | RSComponents
FST3253 | Multiplekser/demultiplekser 2 x 4:1 16-TSSOP | J3 | SOIC127P600X175-16N | FST3253 | 1 |  |  |  |  |  | 74FST3253DR2 |  |  |  |  |  |  | Avnet
MOSFET-N | N-Channel MOSFET | Q1 | E3 | MOSFET-N | 1 |  |  |  |  |  | BS170-D74Z |  |  |  |  |  |  | Avnet
