zizhenji/ECE295_subsystemA-B/BOM_Mar_9.xlsx

Comment | Description | Designator | Footprint | LibRef | Quantity | Manufacturer 1 | Manufacturer 2 | Manufacturer Part Number | Manufacturer Part Number 1 | Supplier 1 | Supplier 2 | Supplier Part Number 1 | Supplier Part Number 2
LED2 | Typical RED, GREEN, YELLOW, AMBER GaAs LED | D1, D2 | 3.2X1.6X1.1 | LED2 | 2 |  |  |  |  | Digi-Key, Future Electronics |  | 754-1884-ND, 9148283
OP_AMP_SOCKET | 8 _2 x 4_ Pos DIP, 0.3 _7.62mm_ Row Spacing Socket Tin Through Hole | J4 | TE_1-2199298-2 | 1-2199298-2 | 1 |  |  |  |  | RSComponents | RSComponents |  | 6742435
MOSFET-N | N-Channel MOSFET | Q1 | E3 | MOSFET-N | 1 |  |  |  |  | Avnet |  | BS170-D74Z
