zizhenji/ECE295_subsystemA-B/Sub_A.xlsx

Comment | Description | Designator | Footprint | LibRef | Quantity | Manufacturer 1 | Manufacturer Part Number | Manufacturer Part Number 1 | Supplier Order Qty 1 | Supplier Part Number 1 | Supplier Stock 1 | Supplier Subtotal 1 | Supplier Subtotal per Board 1
Inductor Iron | VHF-CHOKE 2uH 4A, Fixed Ind 470NH 5A 27 Mohm Th | L1, L2, L3 | AXIAL-0.9 | Inductor Iron | 3 |  | B82132A5402M, B78108E1471M009 |  |  | 8807152P, 495-76024-1-ND
