zizhenji/ECE295_subsystemA-B/Sub_B_PCB.xlsx

Comment | Description | Designator | Footprint | LibRef | Quantity | Manufacturer 1 | Manufacturer 2 | Manufacturer 3 | Manufacturer Part Number | Manufacturer Part Number 1 | Supplier 1 | Supplier 2 | Supplier Part Number 1 | Supplier Part Number 2
Cap | Capacitor | C1, C2, C3, C4, C7, C8, C9, C10 | RADIAL-0.1 | CAP ALUM 10UF 20% 63V RADIAL, CAP CER 100PF 50V C0G/NP0 RADIAL, CAP CER 0.22UF 50V Z5U RADIAL | 8 |  |  |  | ESK106M063AC3FA, K101K15C0GF53L2, C320C224M5U5TA
Cap | Capacitor | C5, C6 | 1206 | CAP CER 10UF 25V X5R 1206 | 2 |  |  |  | 885012108021
LED0 | Typical INFRARED GaAs LED | D1, D2 | LED-0 | LED0 | 2 |  |  |  |  |  | Digi-Key | [NoParam], Future Electronics | 754-1884-ND, [NoParam]
OP_AMP_SOCKET | 8 _2 x 4_ Pos DIP, 0.3 _7.62mm_ Row Spacing Socket Tin Through Hole | J1 | TE_1-2199298-2 | 1-2199298-2 | 1 |  |  |  |  |  | RSComponents | RSComponents |  | 6742435
FST3253 | Multiplekser/demultiplekser 2 x 4:1 16-TSSOP | J3 | SOIC127P600X175-16N | FST3253 | 1
Header 4 | Header, 4-Pin | J4, J5, J6 | HDR1X4 | Header 4 | 3
BUS1_0_TP | Header, 2-Pin | P1 | HDR1X2 | Header 2 | 1
BUS2_0_TP | Header, 2-Pin | P2 | HDR1X2 | Header 2 | 1
BUS1_90_TP | Header, 2-Pin | P3 | HDR1X2 | Header 2 | 1
BUS2_90_TP | Header, 2-Pin | P4 | HDR1X2 | Header 2 | 1
BUS1_270_TP | Header, 2-Pin | P5 | HDR1X2 | Header 2 | 1
BUS2_270_TP | Header, 2-Pin | P6 | HDR1X2 | Header 2 | 1
BUS1_180_TP | Header, 2-Pin | P7 | HDR1X2 | Header 2 | 1
BUS2_180_TP | Header, 2-Pin | P8 | HDR1X2 | Header 2 | 1
OP1_N_TP | Header, 2-Pin | P9 | HDR1X2 | Header 2 | 1
OP2_P_TP | Header, 2-Pin | P10 | HDR1X2 | Header 2 | 1
OP1_P_TP | Header, 2-Pin | P11 | HDR1X2 | Header 2 | 1
OP_N_TP | Header, 2-Pin | P12 | HDR1X2 | Header 2 | 1
MOSFET-N | N-Channel MOSFET | Q1 | E3 | MOSFET-N | 1 |  |  |  |  |  | Avnet |  | BS170-D74Z
Res1 | Resistor | Rx1, Rx2, Rx3, Rx4, Rx5, Rx6, Rx7, Rx8, Rx9, Rx10, Rx11, Rx12, Rx13, Rx14, Rx15, Rx16 | AXIAL-0.1-RES | RES 100K OHM 5% 1/4W AXIAL, RES 3.3K OHM 5% 1/4W AXIAL, RES 15K OHM 5% 1/4W AXIAL, RES 56 OHM 5% 1/4W AXIAL, RES 12K OHM 5% 1/4W AXIAL, RES 22K OHM 5% 1/4W AXIAL | 16 |  |  |  | CFR-25JB-52-100K, CFR-25JB-52-3K3, CFR-25JB-52-15K, CFR-25JB-52-56R, CFR-25JB-52-12K, CFR-25JB-52-22K
Trans CT | Center-Tapped Transformer (Coupled Inductor Model) | T1 | BIFILAR-2402 | Centre-tapped transformer wound on a binocular core | 1
