zizhenji/ECE295_subsystemA-B/simulation_results/96kHz_LPA.docx

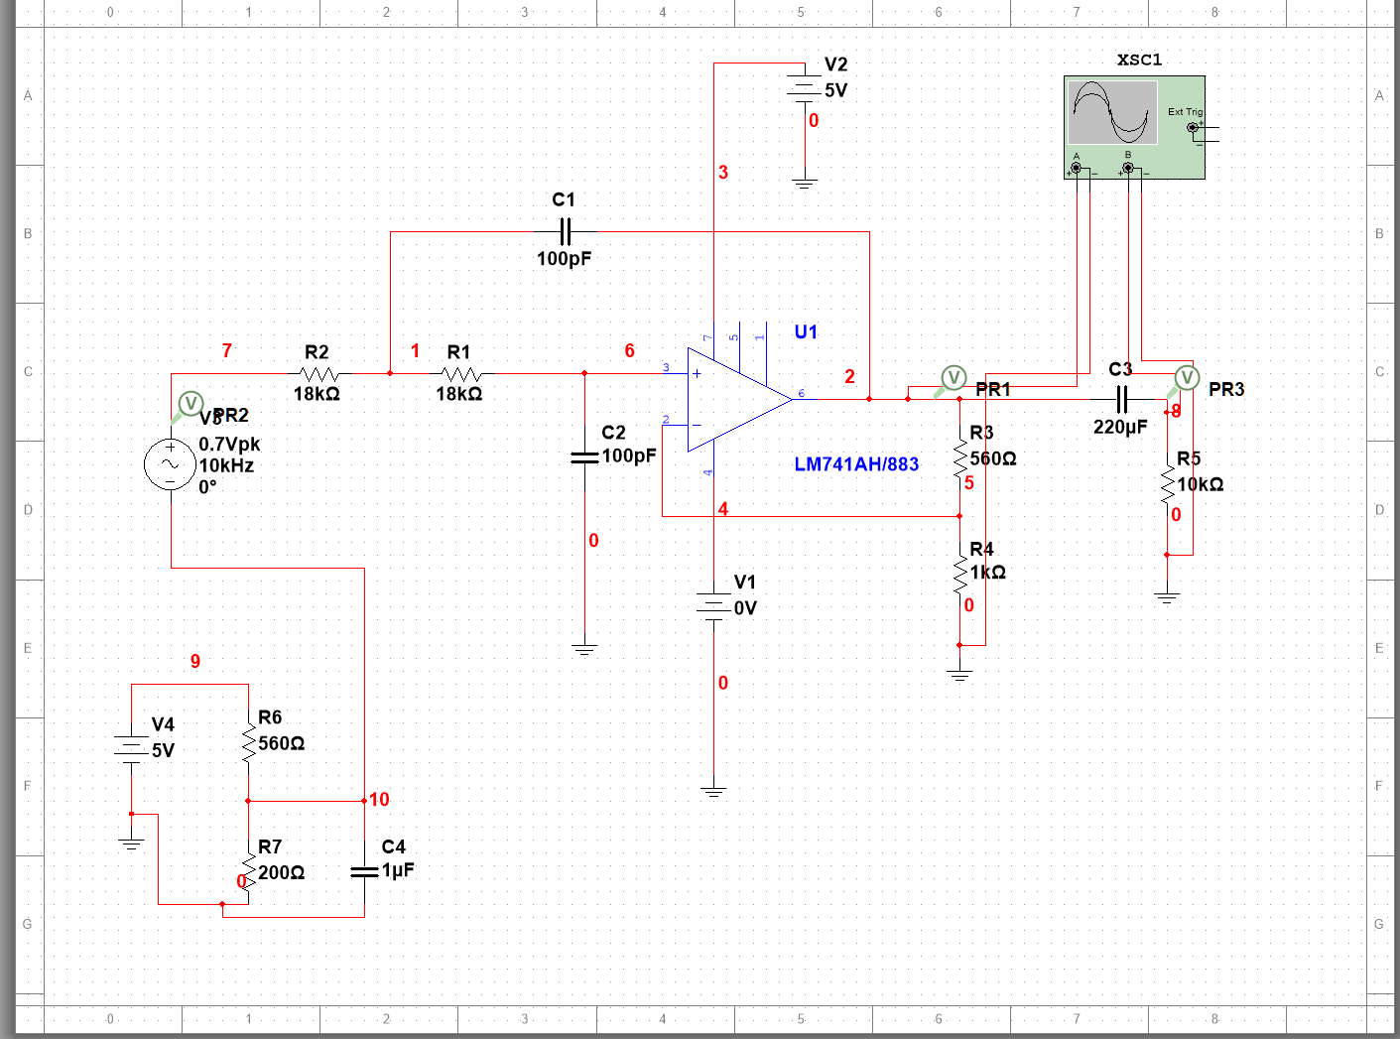
[picture p44: figure]

1.3v biased 96kHz cutoff LPA

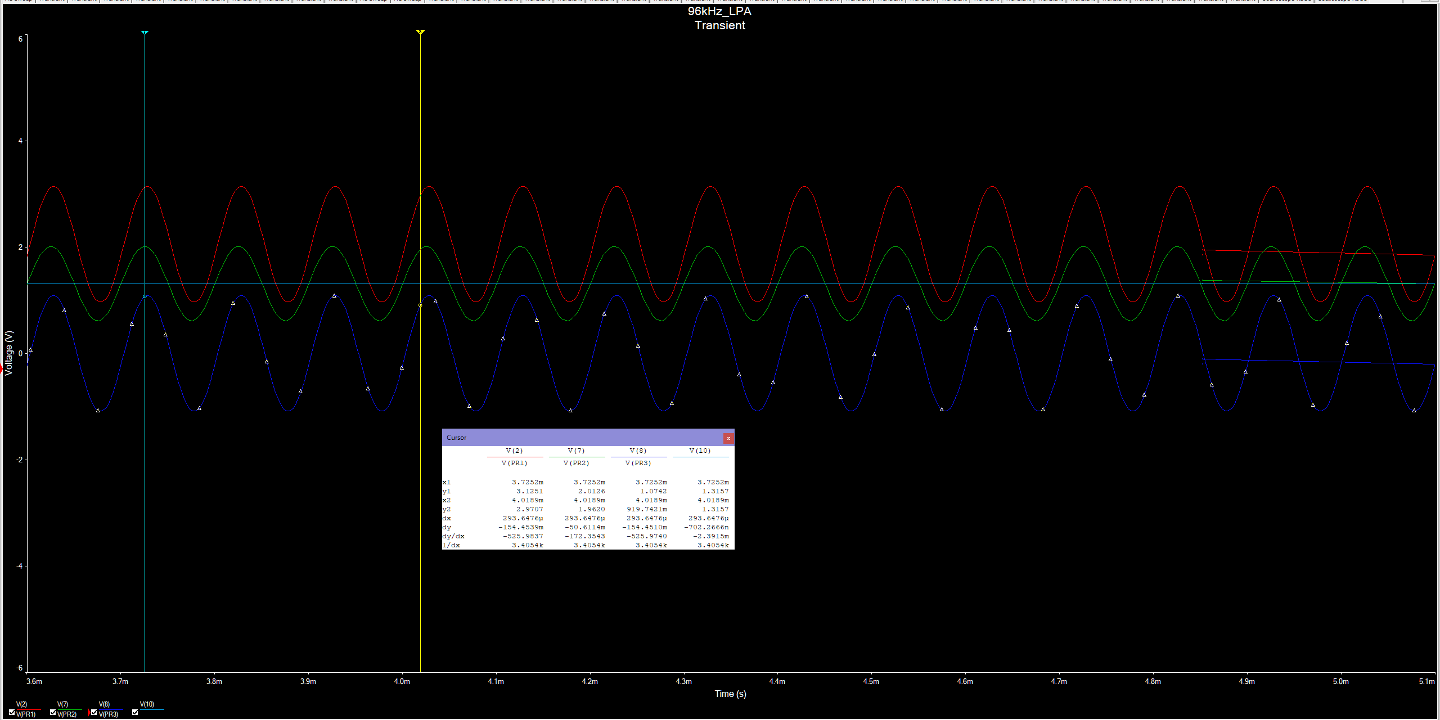
[picture p45: figure]

Green: -0.7~+0.7v input; Red: DC biased filter output at 10kHz; blue: AC coupled output.

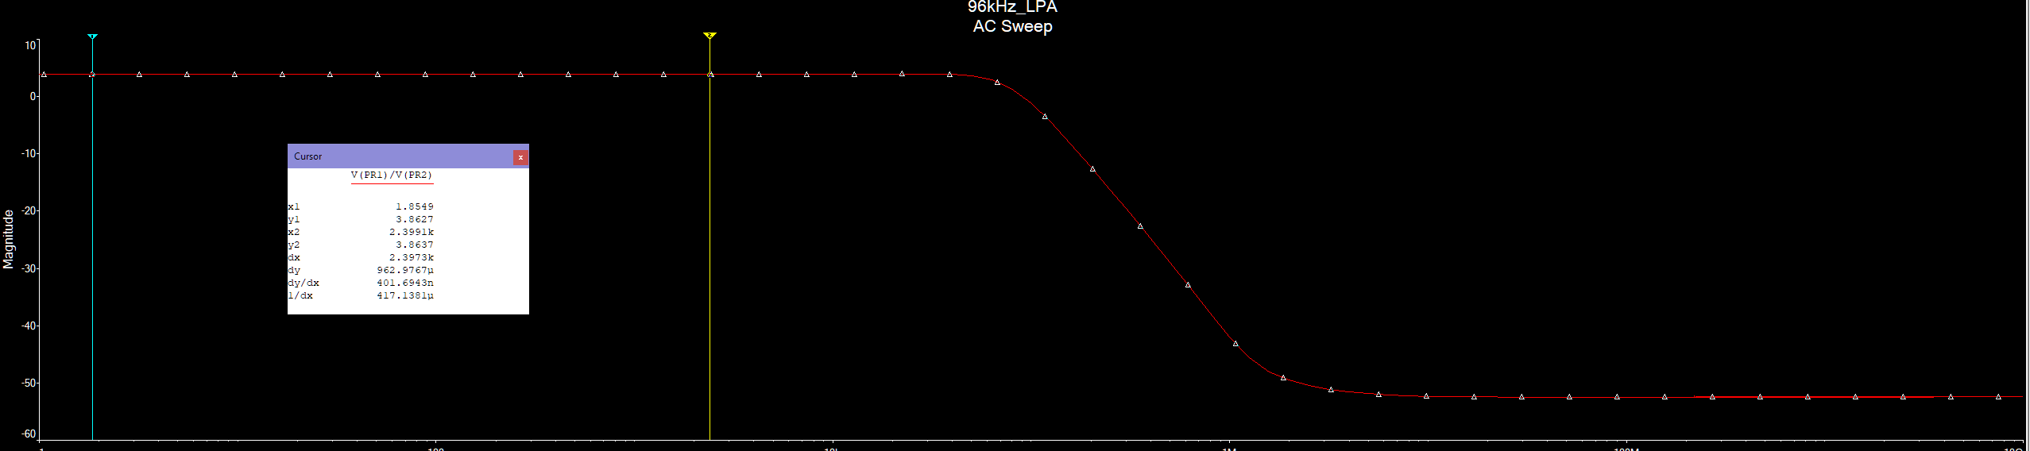
[picture p46: figure]

Low pass gain 3.86dB

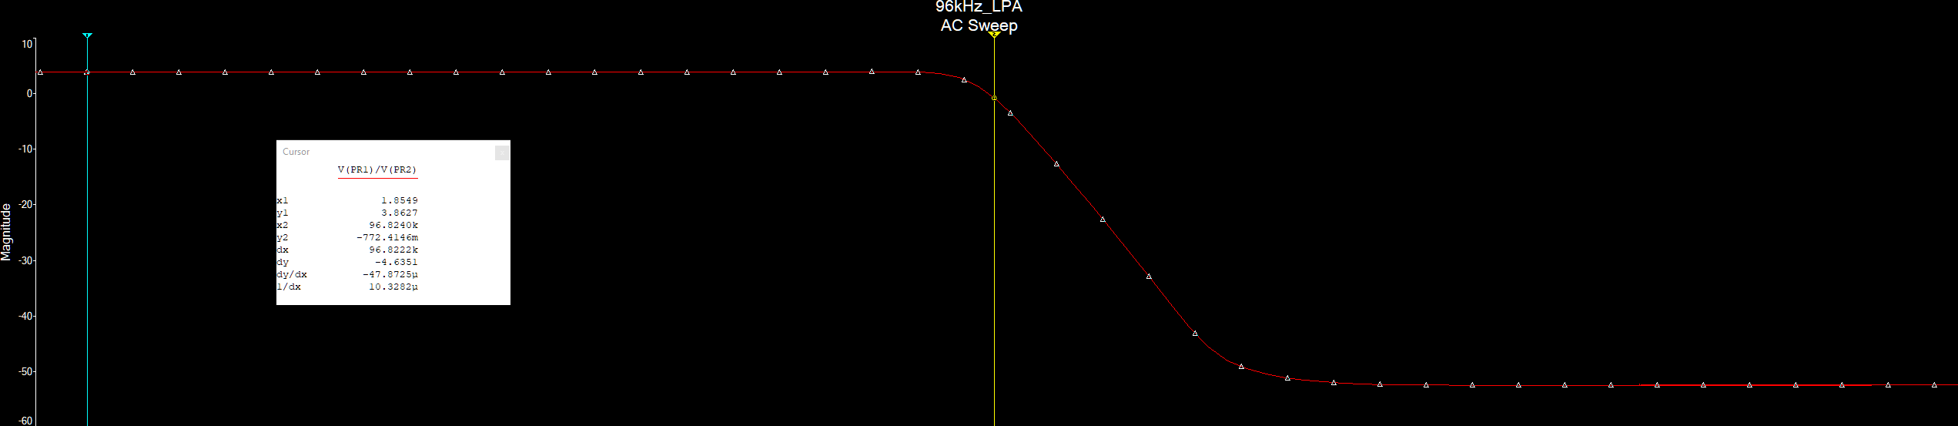
[picture p47: figure]

Around 0 dB gain at 96kHz, which is around -3dB from pass band gain
