zizhenji/ECE295_subsystemA-B/simulation_results/Sub_B.docx

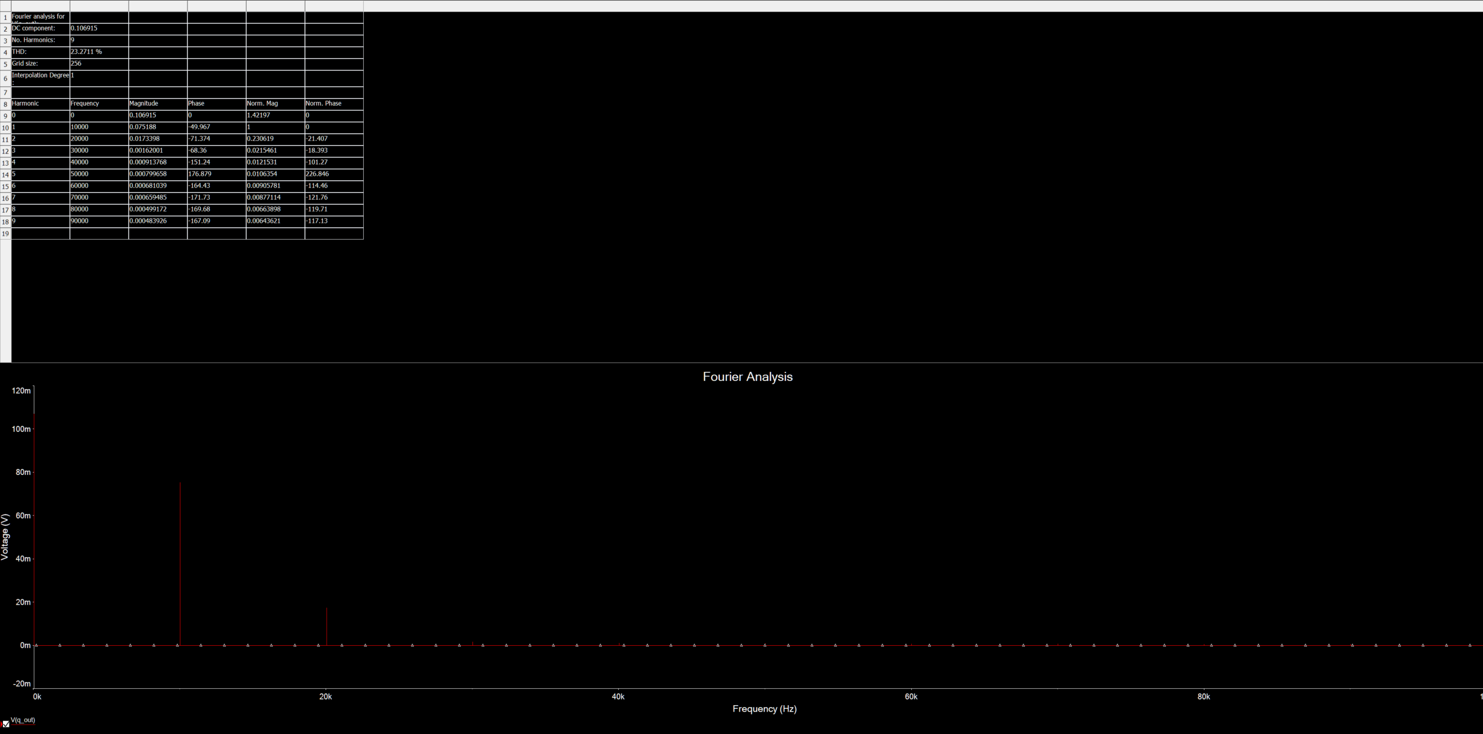
[picture p48: figure]

Mixer Q Fourier analysis

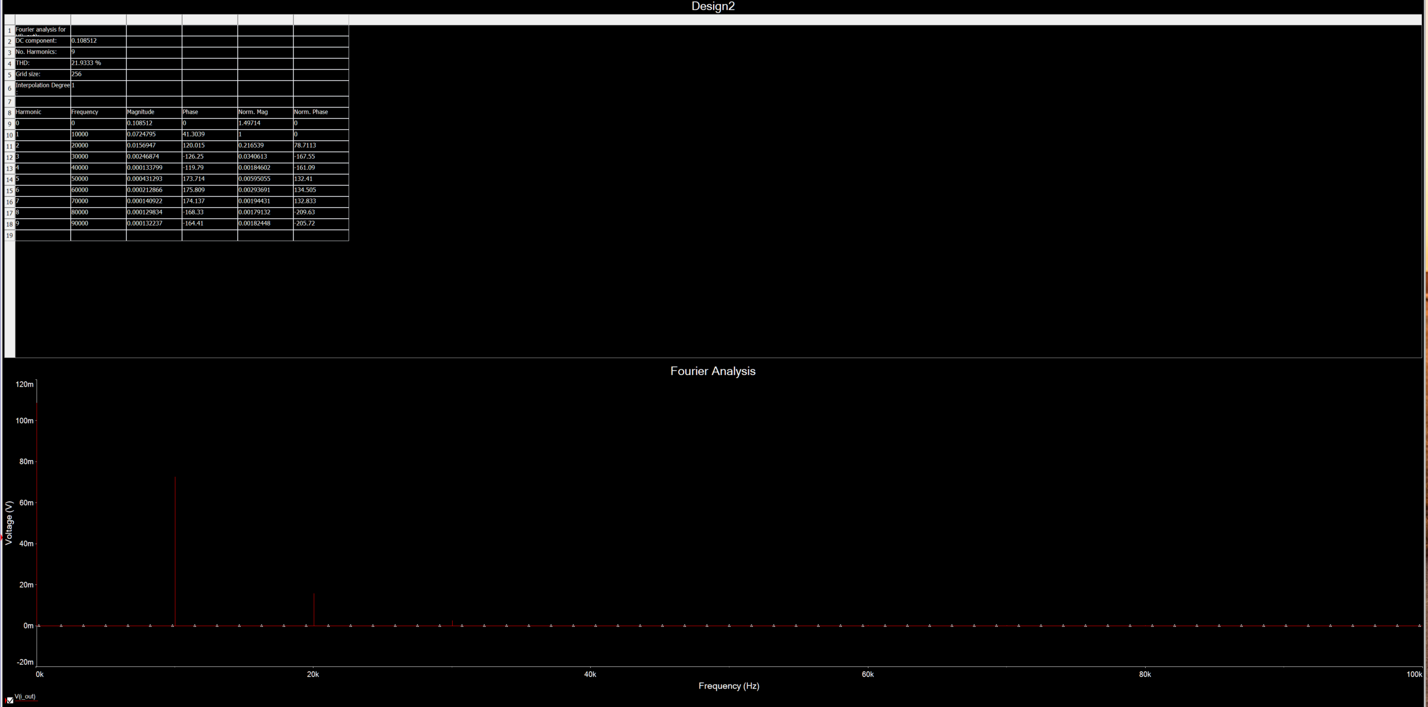
[picture p49: figure]

Mixer I Fourier analysis

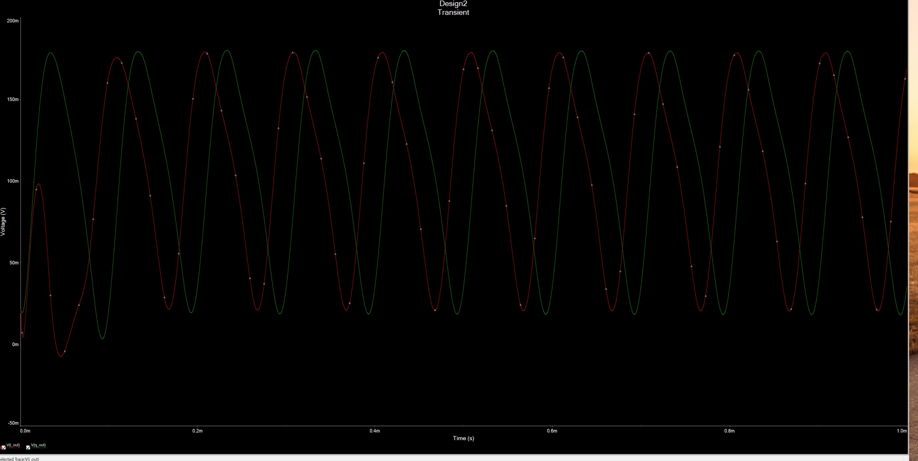
[picture p50: figure]

mixer IQ transient simulation

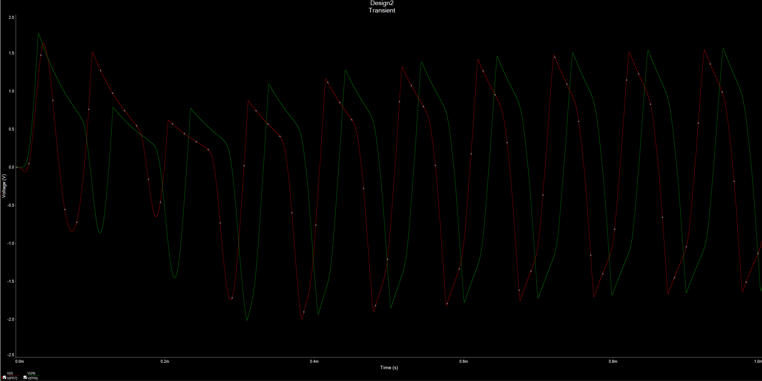
[picture p51: figure]

Subsystem B output

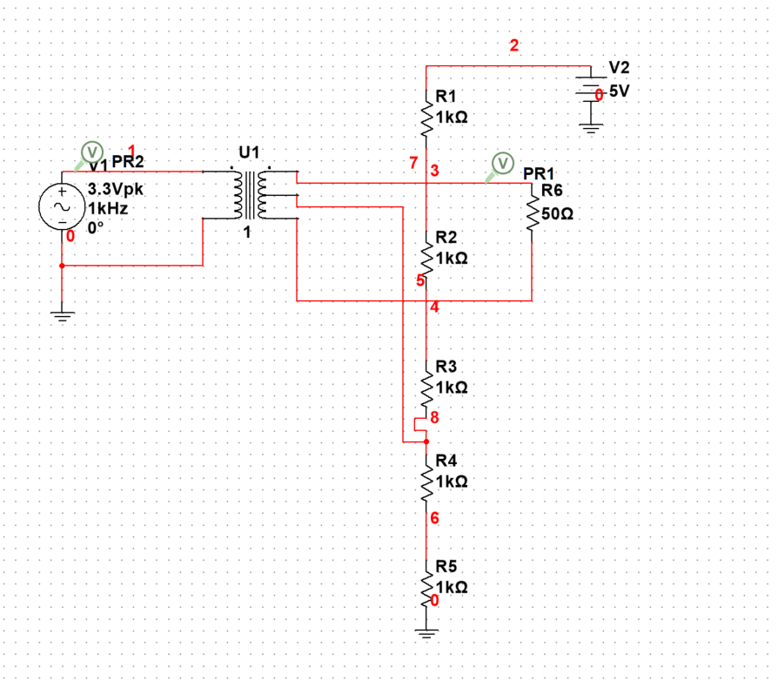
[picture p52: figure]

LO Bias circuit -bias to 2v (FST3253 minimum HIGH)

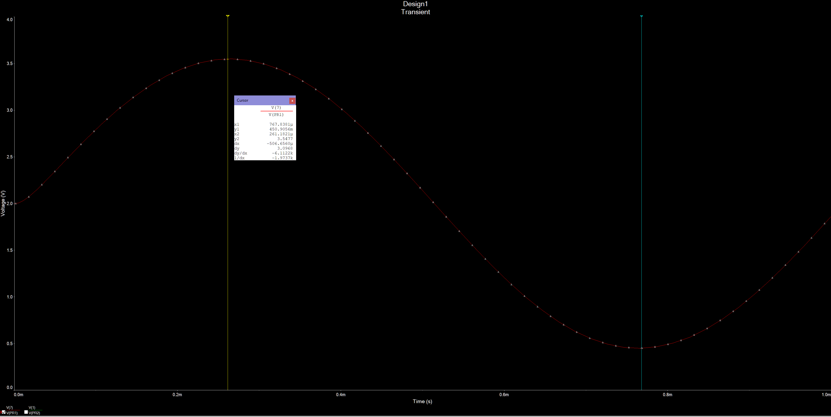
[picture p53: figure]

LO biased signal output (FST3253 max LOW =0.8v, max HIGH=5.5v)

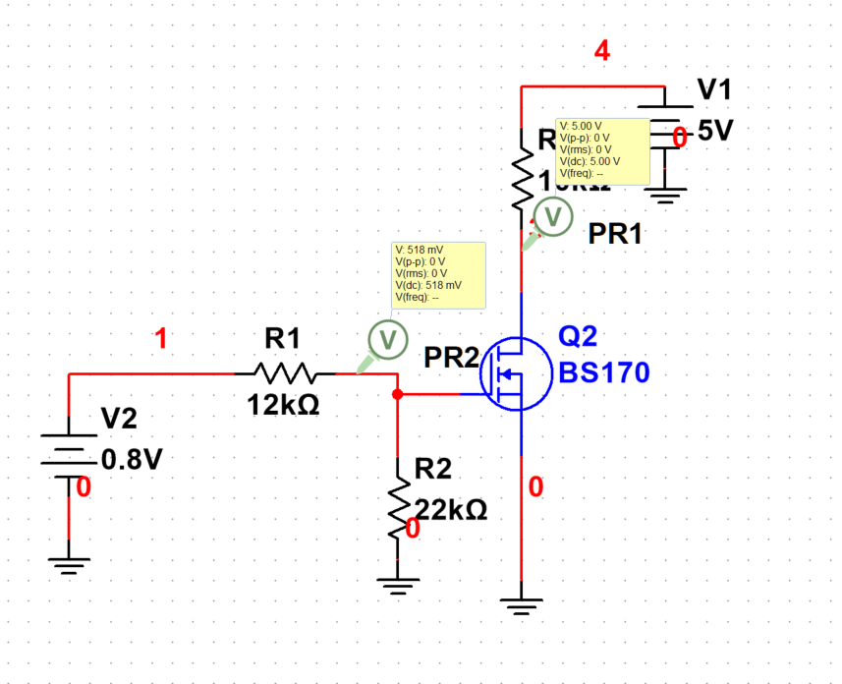
[picture p54: figure]

TX Enable circuits when TXEN LOW (0.8v) with 5v output to disable demux

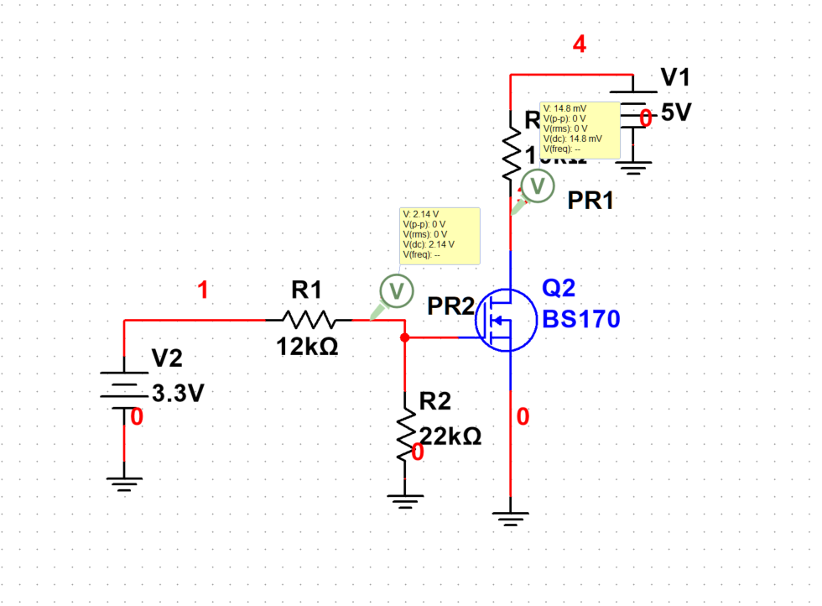
[picture p55: figure]

TX Enable circuits when TXEN HIGH (3.3v) with 14.8mV output to enable demux
