zizhenji/ECE295_subsystemA-B/simulation_results/BPF_8_16MHz.docx

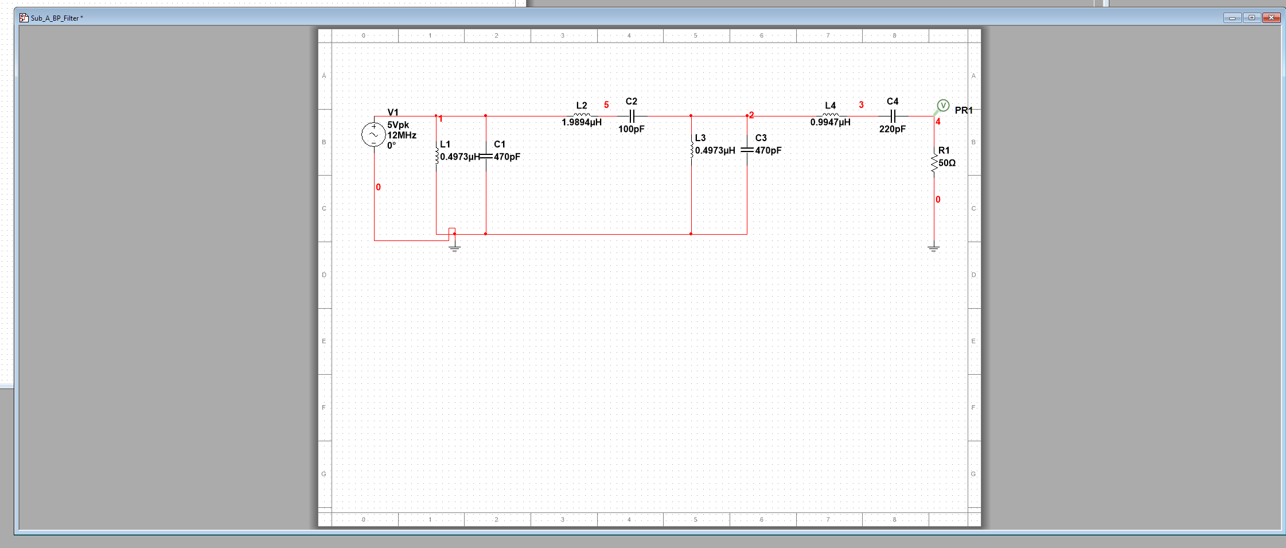
[picture p56: figure]

Simulation profile

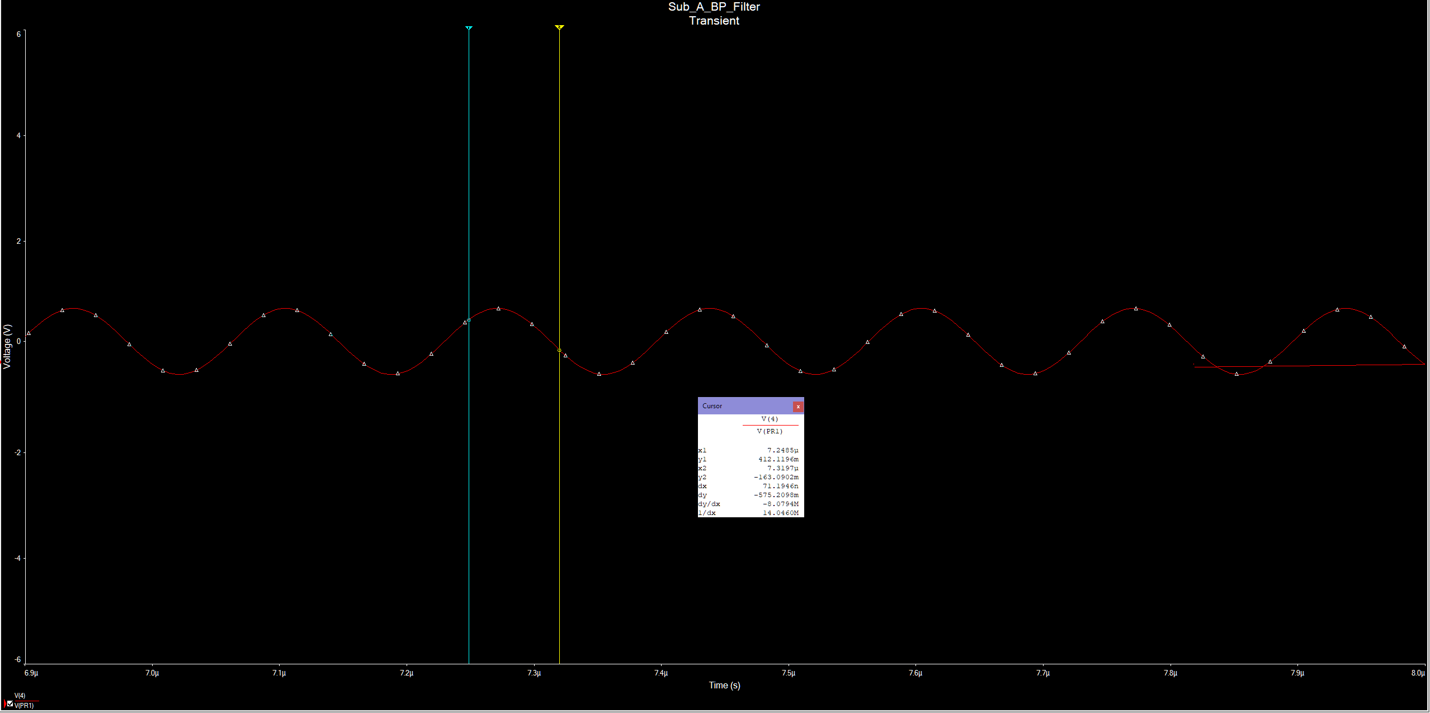
[picture p57: figure]

6MHz out-of-band gain

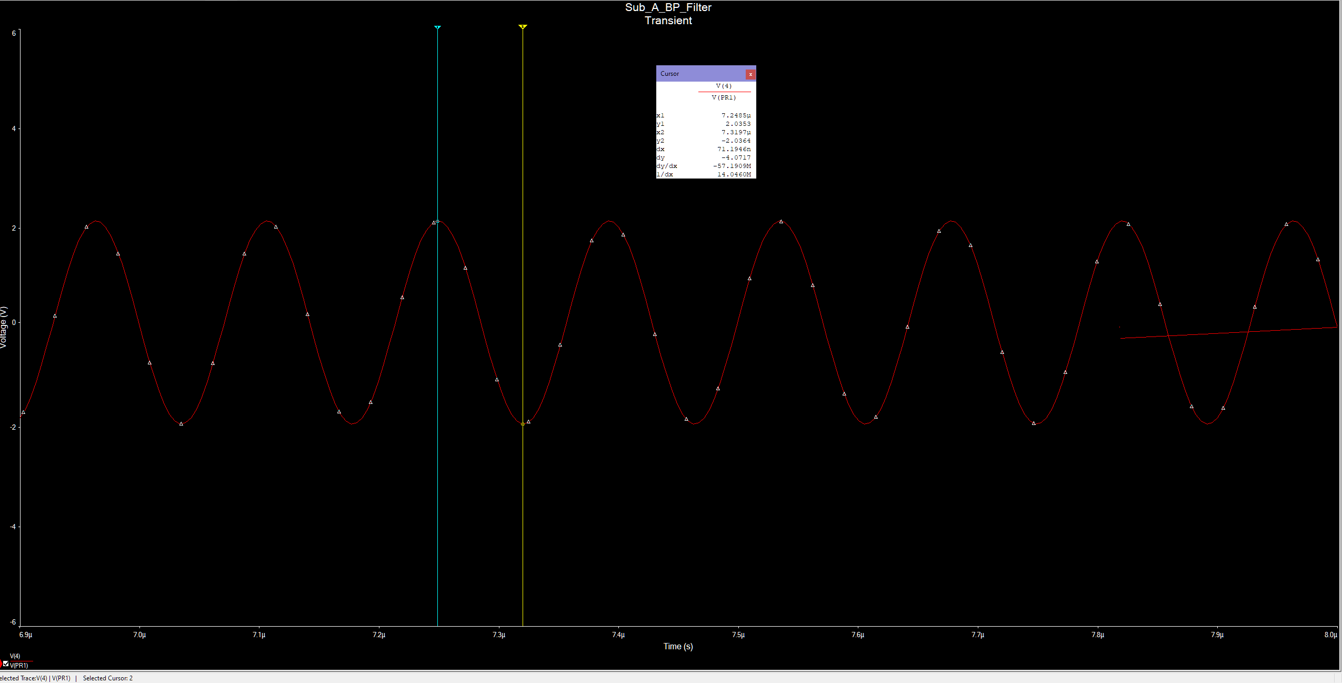
[picture p58: figure]

7MHz out-of-band gain

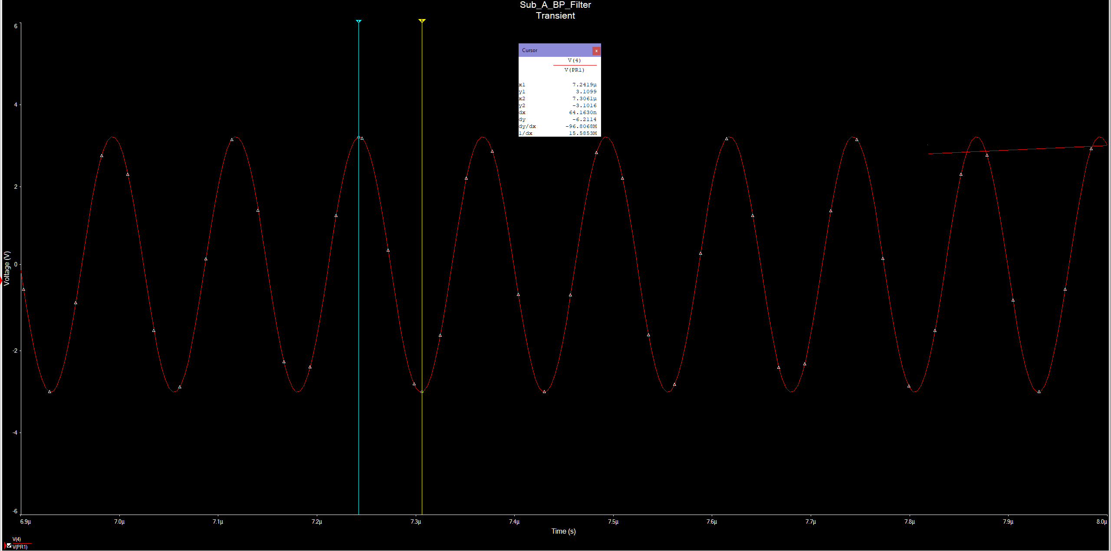
[picture p59: figure]

8MHz in-band gain

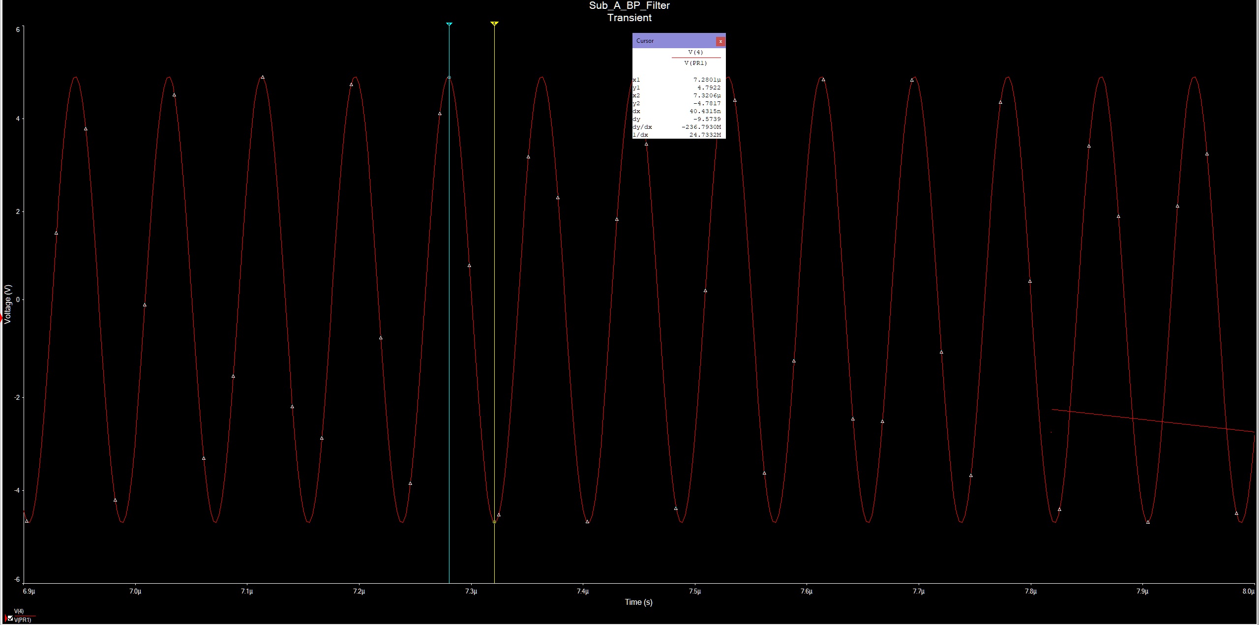
[picture p60: figure]

12MHz center-frequency gain

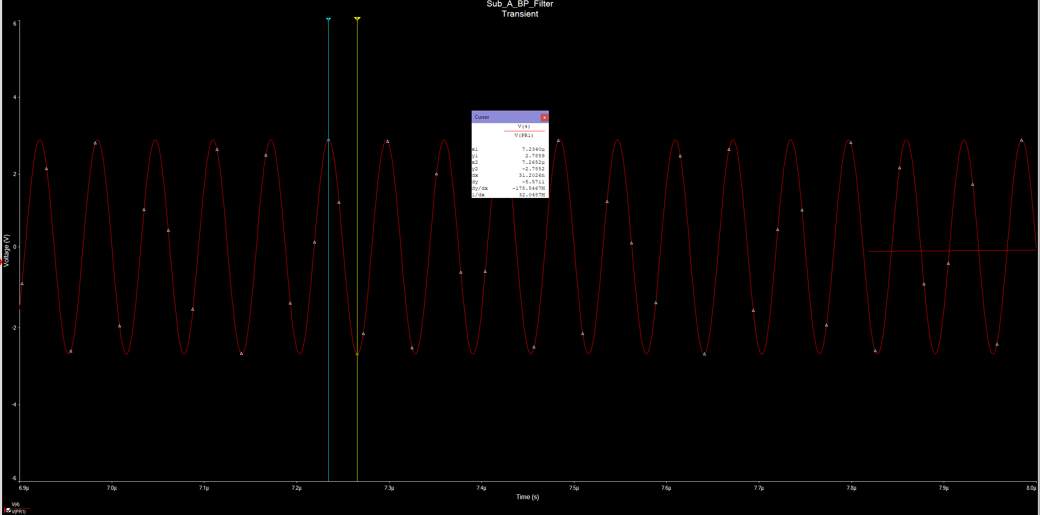
[picture p61: figure]

16MHz in-band gain

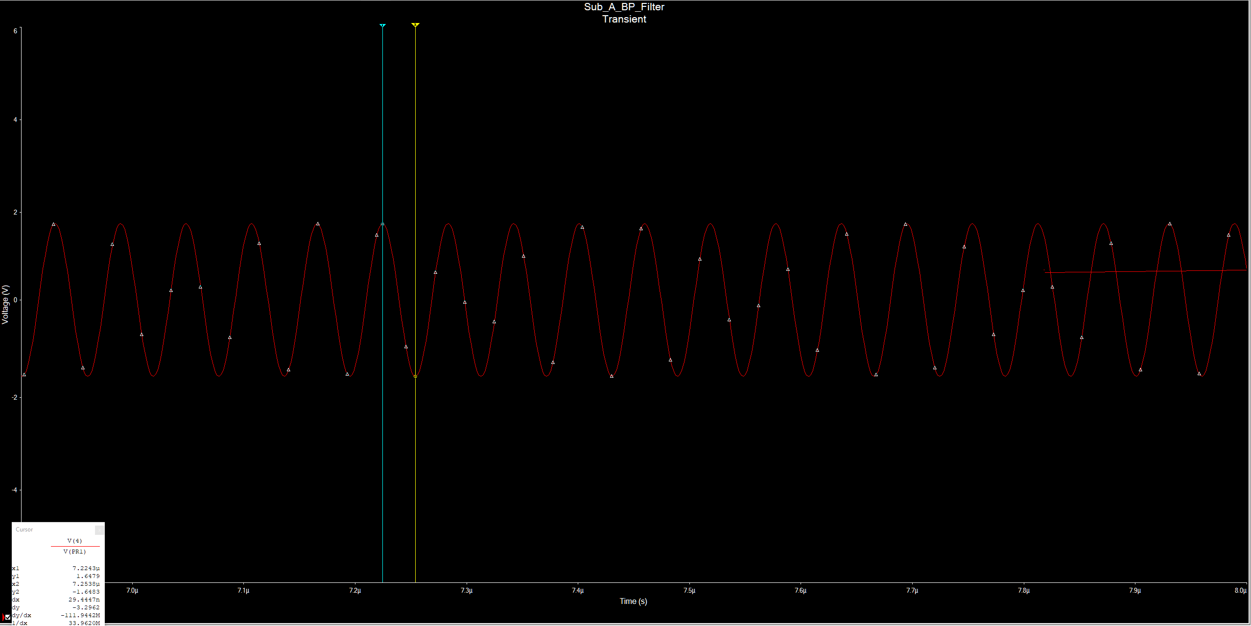
[picture p62: figure]

17MHz out-of-band gain
