zizhenji/ECE295_subsystemA-B/(list of files, drawings)

Other design files:
96kHz_LPF.SchDoc
altium_lib/SOIC127P600X175-16N.PcbLib
IQ_AMP.SchDoc
limiter.SchDoc
mixer.SchDoc
multisim_models/96kHz_LPA.ms14
multisim_models/Design2.ms14
multisim_models/IF_amplifier.ms14
multisim_models/LO_bias.ms14
multisim_models/LPA_AMP.ms14
multisim_models/mixer_2.ms14
multisim_models/Sub_A_BP_Filter.ms14
multisim_models/Sub_B.ms14
multisim_models/tayloe_detector.ms14
multisim_models/team010_test.ms14
multisim_models/TXEN.ms14
Sub-A_BPF.SchDoc
Sub_A.PrjPcb
Sub_a.SchDoc
Sub_A_PCB/PCB_Project/limiter.SchDoc
Sub_A_PCB/PCB_Project/PCB_Project.PrjPcb
Sub_A_PCB/PCB_Project/Sub-A_BPF.SchDoc
Sub_A_PCB/PCB_Project/Sub_A_PCB.PcbDoc
Sub_B_PCB/Sub_B_PCB/Sub_B_PCB.PrjPcb
Sub_B_PCB/Sub_B_PCB/Sub_B_PCB.SchDoc
Sub_B_PCB/Sub_B_PCB/SUB_BPCB.PcbDoc
Sub_B_pcb_2/Sub_B_PCB_2/Sub_B_PCB.SchDoc
Sub_B_pcb_2/Sub_B_PCB_2/Sub_B_PCB_2.PcbDoc
Sub_B_pcb_2/Sub_B_PCB_2/Sub_B_PCB_2.PrjPcb
