zizhenji/ECE295_subsystemA-B/(commit log)

2022-03-25 Completed design files
    [96kHz_LPA.ms14, 96kHz_LPF.SchDoc, BOM.xlsx, BOM_Mar_20.xlsx, BOM_Mar_9.xlsx, Design2.ms14, IF_amplifier.ms14, IQ_AMP.SchDoc]
2022-04-04 added pull up resistor for TXEN
    [Design2.ms14, Sub_A_PCB.PcbDoc, Sub_B_PCB.SchDoc, Sub_B_PCB_2.PcbDoc, Sub_B_PCB_2.PrjPcb, TXEN.ms14, mixer_2.ms14]
